felixomwansa/Multi-Protocol-Board---MPB-01/doc/block diagram.pdf

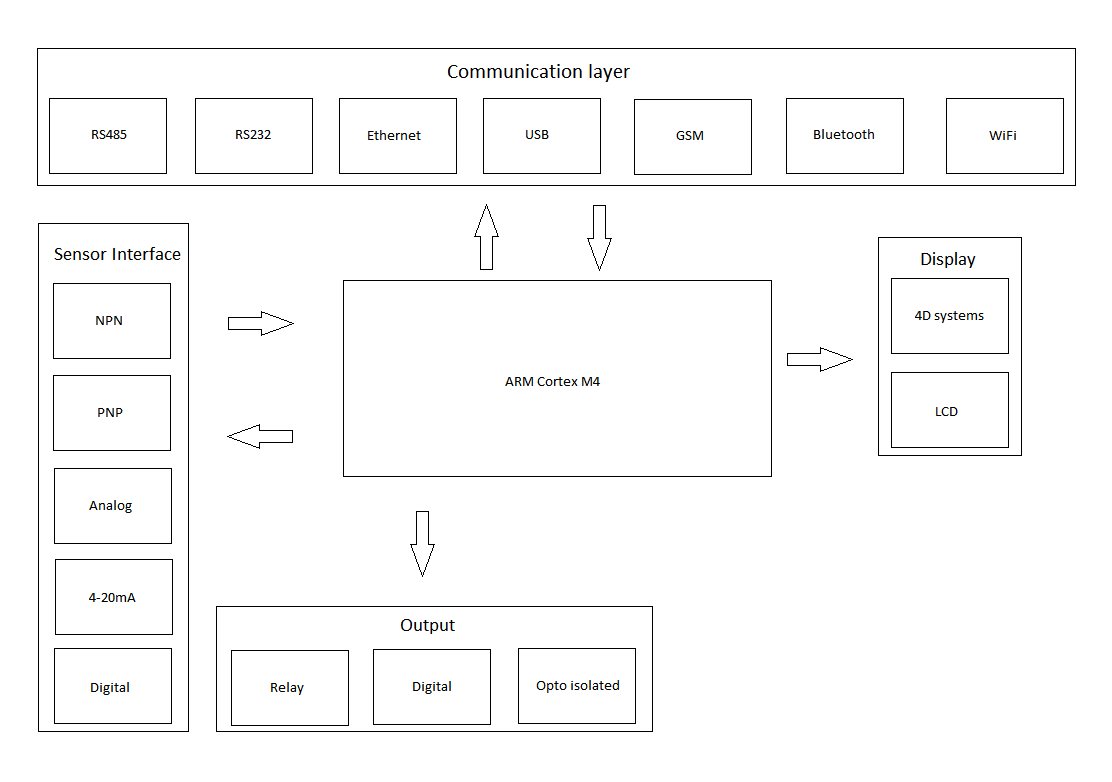
[picture p1: figure]
