felixomwansa/Multi-Protocol-Board---MPB-01/doc/PinmapVET6.jpg

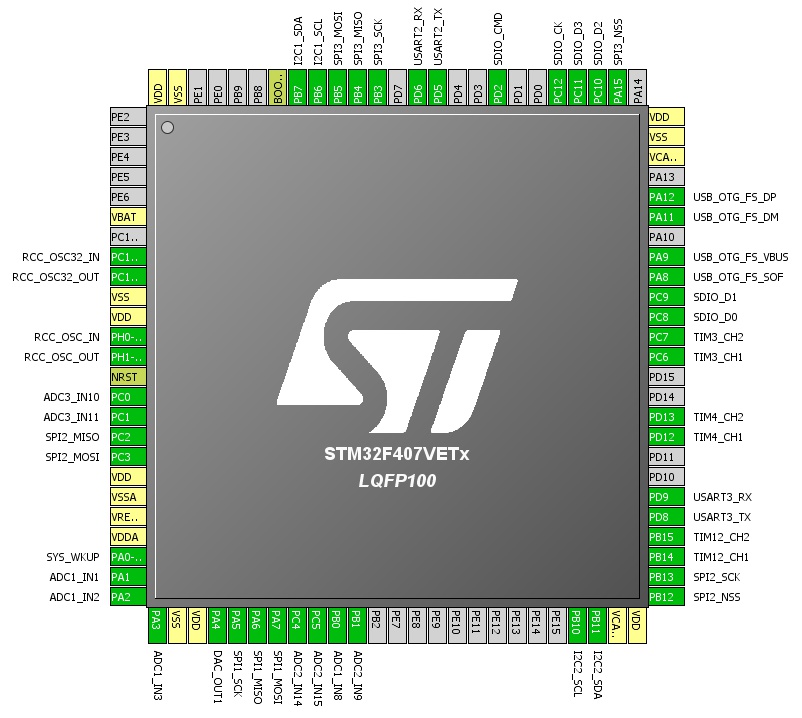
doc/PinmapVET6.jpg
