felixomwansa/Multi-Protocol-Board---MPB-01/v1.1 - Serial COM board/schema_mpb_1_1_Serial.brd

## EAGLE design v1.1 - Serial COM board/schema_mpb_1_1_Serial.brd (2019-08-02)

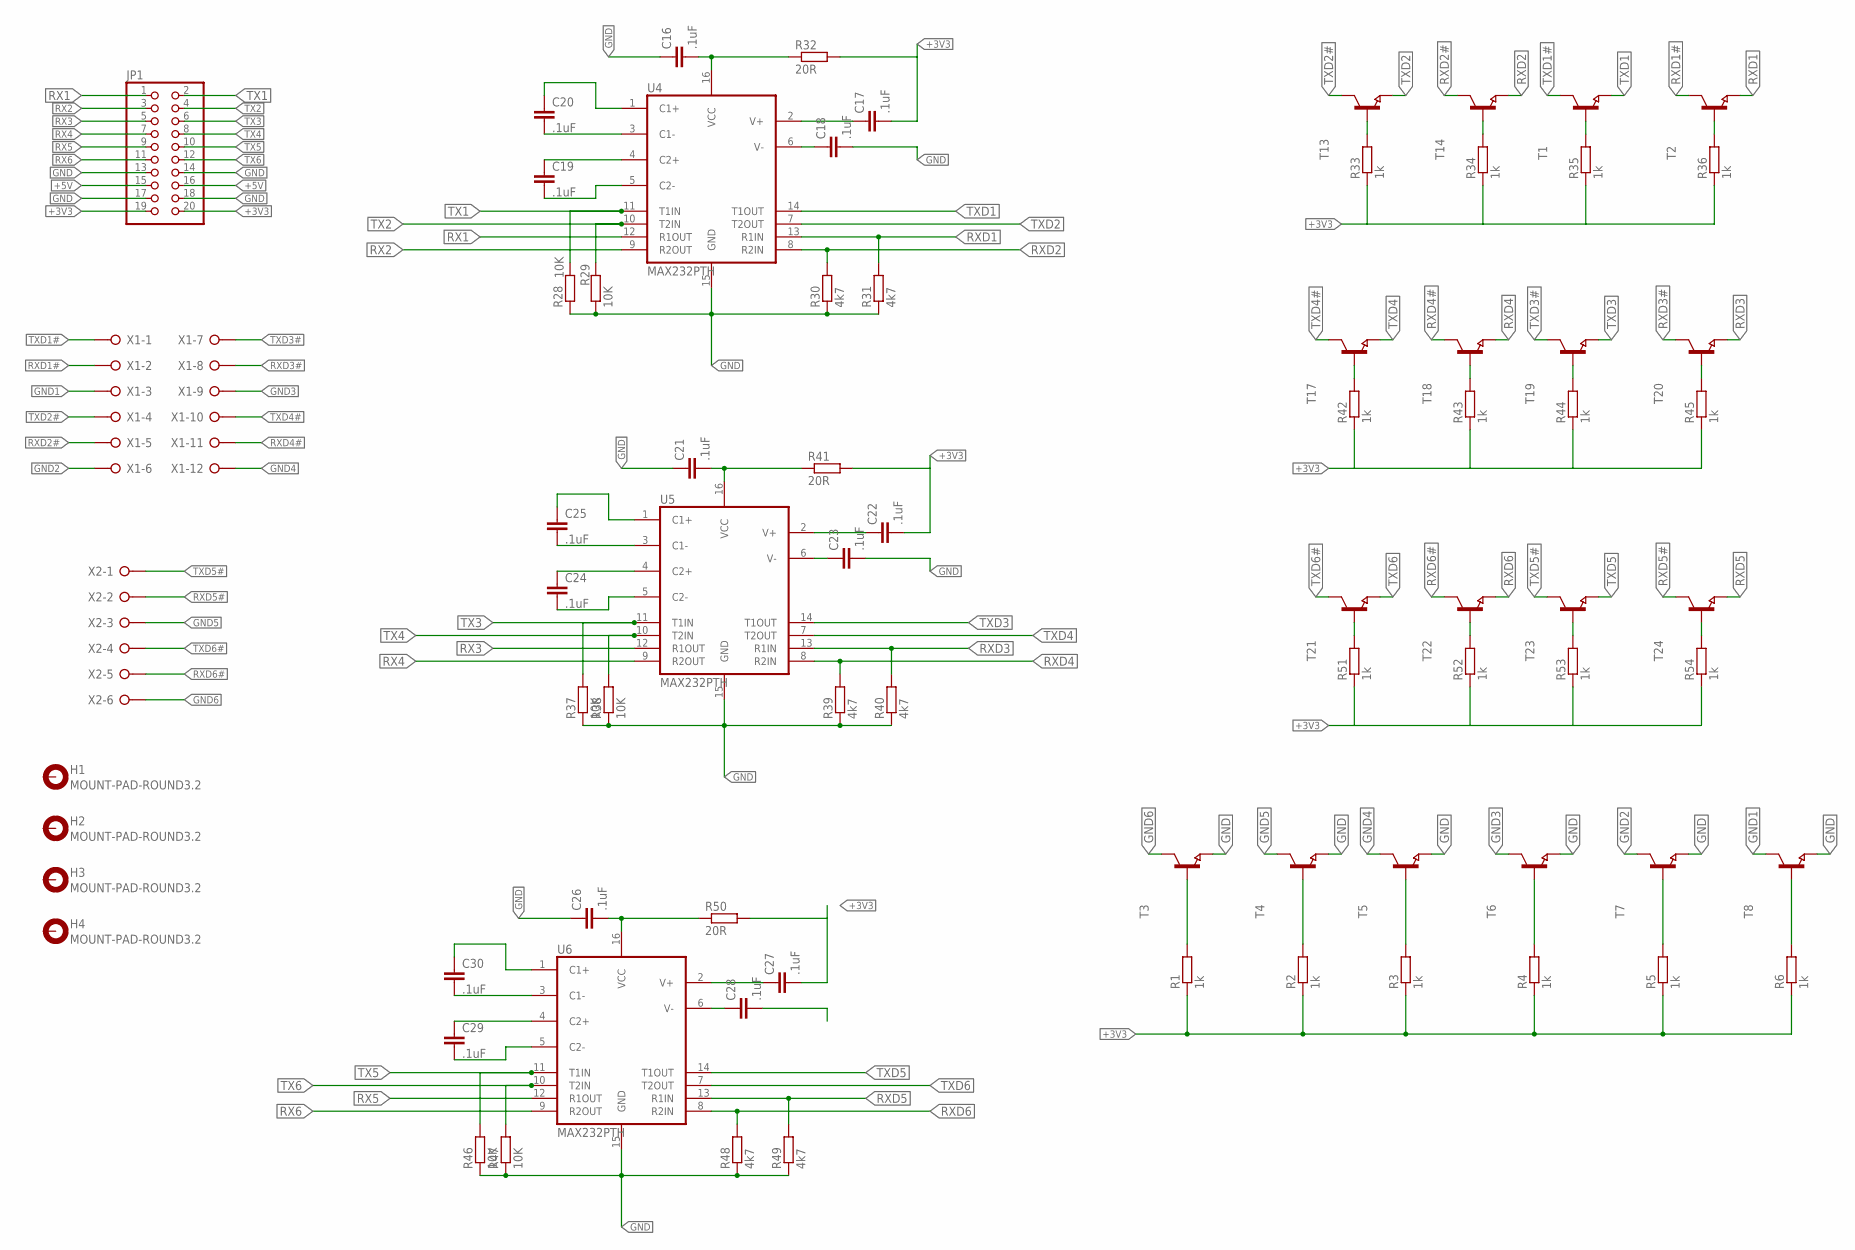
[picture p5: schematic schema_mpb_1_1_Serial.sch]

Parts:
C16, C17, C18, C19, C20, C21, C22, C23, C24, C25, C26, C27, C28, C29, C30: .1uF; C0603
H1, H2, H3, H4: MOUNT-PAD-ROUND3.2; 3,2-PAD
JP1: PINHD-2X10; 2X10
R1, R2, R3, R4, R5, R6, R33, R34, R35, R36, R42, R43, R44, R45, R51, R52, R53, R54: 1k; R0603
R28, R29, R37, R38, R46, R47: 10K; R0603
R30, R31, R39, R40, R48, R49: 4k7; R0603
R32, R41, R50: 20R; R0603
T1, T2, T3, T4, T5, T6, T7, T8, T13, T14, T17, T18, T19, T20, T21, T22, T23, T24: NPN-TRANSISTOR_SOT23; SOT23
U4, U5, U6: MAX232PTH; DIL16
X1: W237-12P
X2: W237-06P; W237-6P

Connections:
+3V3: C17.2, C22.2, C27.2, JP1.19, JP1.20, R1.1, R2.1, R3.1, R4.1, R5.1, R6.1, R32.2, R33.1, R34.1, R35.1, R36.1, R41.2, R42.1, R43.1, R44.1, R45.1, R50.2, R51.1, R52.1, R53.1, R54.1
+5V: JP1.15, JP1.16
GND: C16.1, C18.2, C21.1, C23.2, C26.1, C28.2, JP1.13, JP1.14, JP1.17, JP1.18, R28.1, R29.1, R30.1, R31.1, R37.1, R38.1, R39.1, R40.1, R46.1, R47.1, R48.1, R49.1, T3.2 (E), T4.2 (E), T5.2 (E), T6.2 (E), T7.2 (E), T8.2 (E), U4.15 (GND), U5.15 (GND), U6.15 (GND)
GND1: T8.3 (C), X1.3
GND2: T7.3 (C), X1.6
GND3: T6.3 (C), X1.9
GND4: T5.3 (C), X1.12
GND5: T4.3 (C), X2.3
GND6: T3.3 (C), X2.6
unnamed: R1.2, T3.1 (B)
unnamed: R2.2, T4.1 (B)
unnamed: R3.2, T5.1 (B)
unnamed: R4.2, T6.1 (B)
unnamed: R5.2, T7.1 (B)
unnamed: R6.2, T8.1 (B)
unnamed: C20.2, U4.3 (C1-)
unnamed: C20.1, U4.1 (C1+)
unnamed: C19.2, U4.5 (C2-)
unnamed: C19.1, U4.4 (C2+)
unnamed: C18.1, U4.6 (V-)
unnamed: C16.2, R32.1, U4.16 (VCC)
unnamed: C17.1, U4.2 (V+)
unnamed: R33.2, T13.1 (B)
unnamed: R34.2, T14.1 (B)
unnamed: R35.2, T1.1 (B)
unnamed: R36.2, T2.1 (B)
unnamed: C25.2, U5.3 (C1-)
unnamed: C25.1, U5.1 (C1+)
unnamed: C24.2, U5.5 (C2-)
unnamed: C24.1, U5.4 (C2+)
unnamed: C23.1, U5.6 (V-)
unnamed: C21.2, R41.1, U5.16 (VCC)
unnamed: C22.1, U5.2 (V+)
unnamed: R42.2, T17.1 (B)
unnamed: R43.2, T18.1 (B)
unnamed: R44.2, T19.1 (B)
unnamed: R45.2, T20.1 (B)
unnamed: C30.2, U6.3 (C1-)
unnamed: C30.1, U6.1 (C1+)
unnamed: C29.2, U6.5 (C2-)
unnamed: C29.1, U6.4 (C2+)
unnamed: C28.1, U6.6 (V-)
unnamed: C26.2, R50.1, U6.16 (VCC)
unnamed: C27.1, U6.2 (V+)
unnamed: R51.2, T21.1 (B)
unnamed: R52.2, T22.1 (B)
unnamed: R53.2, T23.1 (B)
unnamed: R54.2, T24.1 (B)
RX1: JP1.1, U4.12 (R1OUT)
RX2: JP1.3, U4.9 (R2OUT)
RX3: JP1.5, U5.12 (R1OUT)
RX4: JP1.7, U5.9 (R2OUT)
RX5: JP1.9, U6.12 (R1OUT)
RX6: JP1.11, U6.9 (R2OUT)
RXD1: R31.2, T2.2 (E), U4.13 (R1IN)
RXD1#: T2.3 (C), X1.2
RXD2: R30.2, T14.2 (E), U4.8 (R2IN)
RXD2#: T14.3 (C), X1.5
RXD3: R40.2, T20.2 (E), U5.13 (R1IN)
RXD3#: T20.3 (C), X1.8
RXD4: R39.2, T18.2 (E), U5.8 (R2IN)
RXD4#: T18.3 (C), X1.11
RXD5: R49.2, T24.2 (E), U6.13 (R1IN)
RXD5#: T24.3 (C), X2.2
RXD6: R48.2, T22.2 (E), U6.8 (R2IN)
RXD6#: T22.3 (C), X2.5
TX1: JP1.2, R28.2, U4.11 (T1IN)
TX2: JP1.4, R29.2, U4.10 (T2IN)
TX3: JP1.6, R37.2, U5.11 (T1IN)
TX4: JP1.8, R38.2, U5.10 (T2IN)
TX5: JP1.10, R46.2, U6.11 (T1IN)
TX6: JP1.12, R47.2, U6.10 (T2IN)
TXD1: T1.2 (E), U4.14 (T1OUT)
TXD1#: T1.3 (C), X1.1
TXD2: T13.2 (E), U4.7 (T2OUT)
TXD2#: T13.3 (C), X1.4
TXD3: T19.2 (E), U5.14 (T1OUT)
TXD3#: T19.3 (C), X1.7
TXD4: T17.2 (E), U5.7 (T2OUT)
TXD4#: T17.3 (C), X1.10
TXD5: T23.2 (E), U6.14 (T1OUT)
TXD5#: T23.3 (C), X2.1
TXD6: T21.2 (E), U6.7 (T2OUT)
TXD6#: T21.3 (C), X2.4

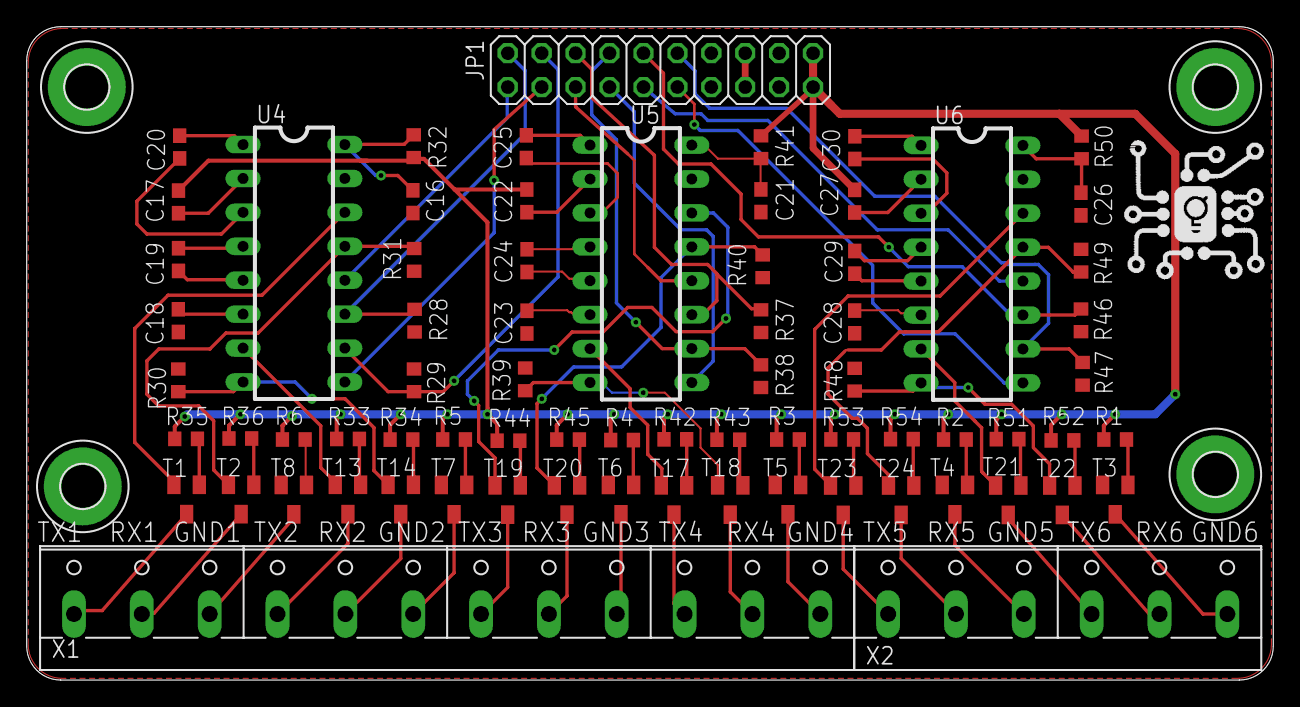
[picture p6: board schema_mpb_1_1_Serial.brd from above]

Board: 2 copper layers, 93.3 x 48.9 mm, 76 parts (0 on the bottom side), 84 nets.
