felixomwansa/Multi-Protocol-Board---MPB-01/v1.1 - COM board/schema_mpb_1_1_COM.brd

## EAGLE design v1.1 - COM board/schema_mpb_1_1_COM.brd (2019-08-02)

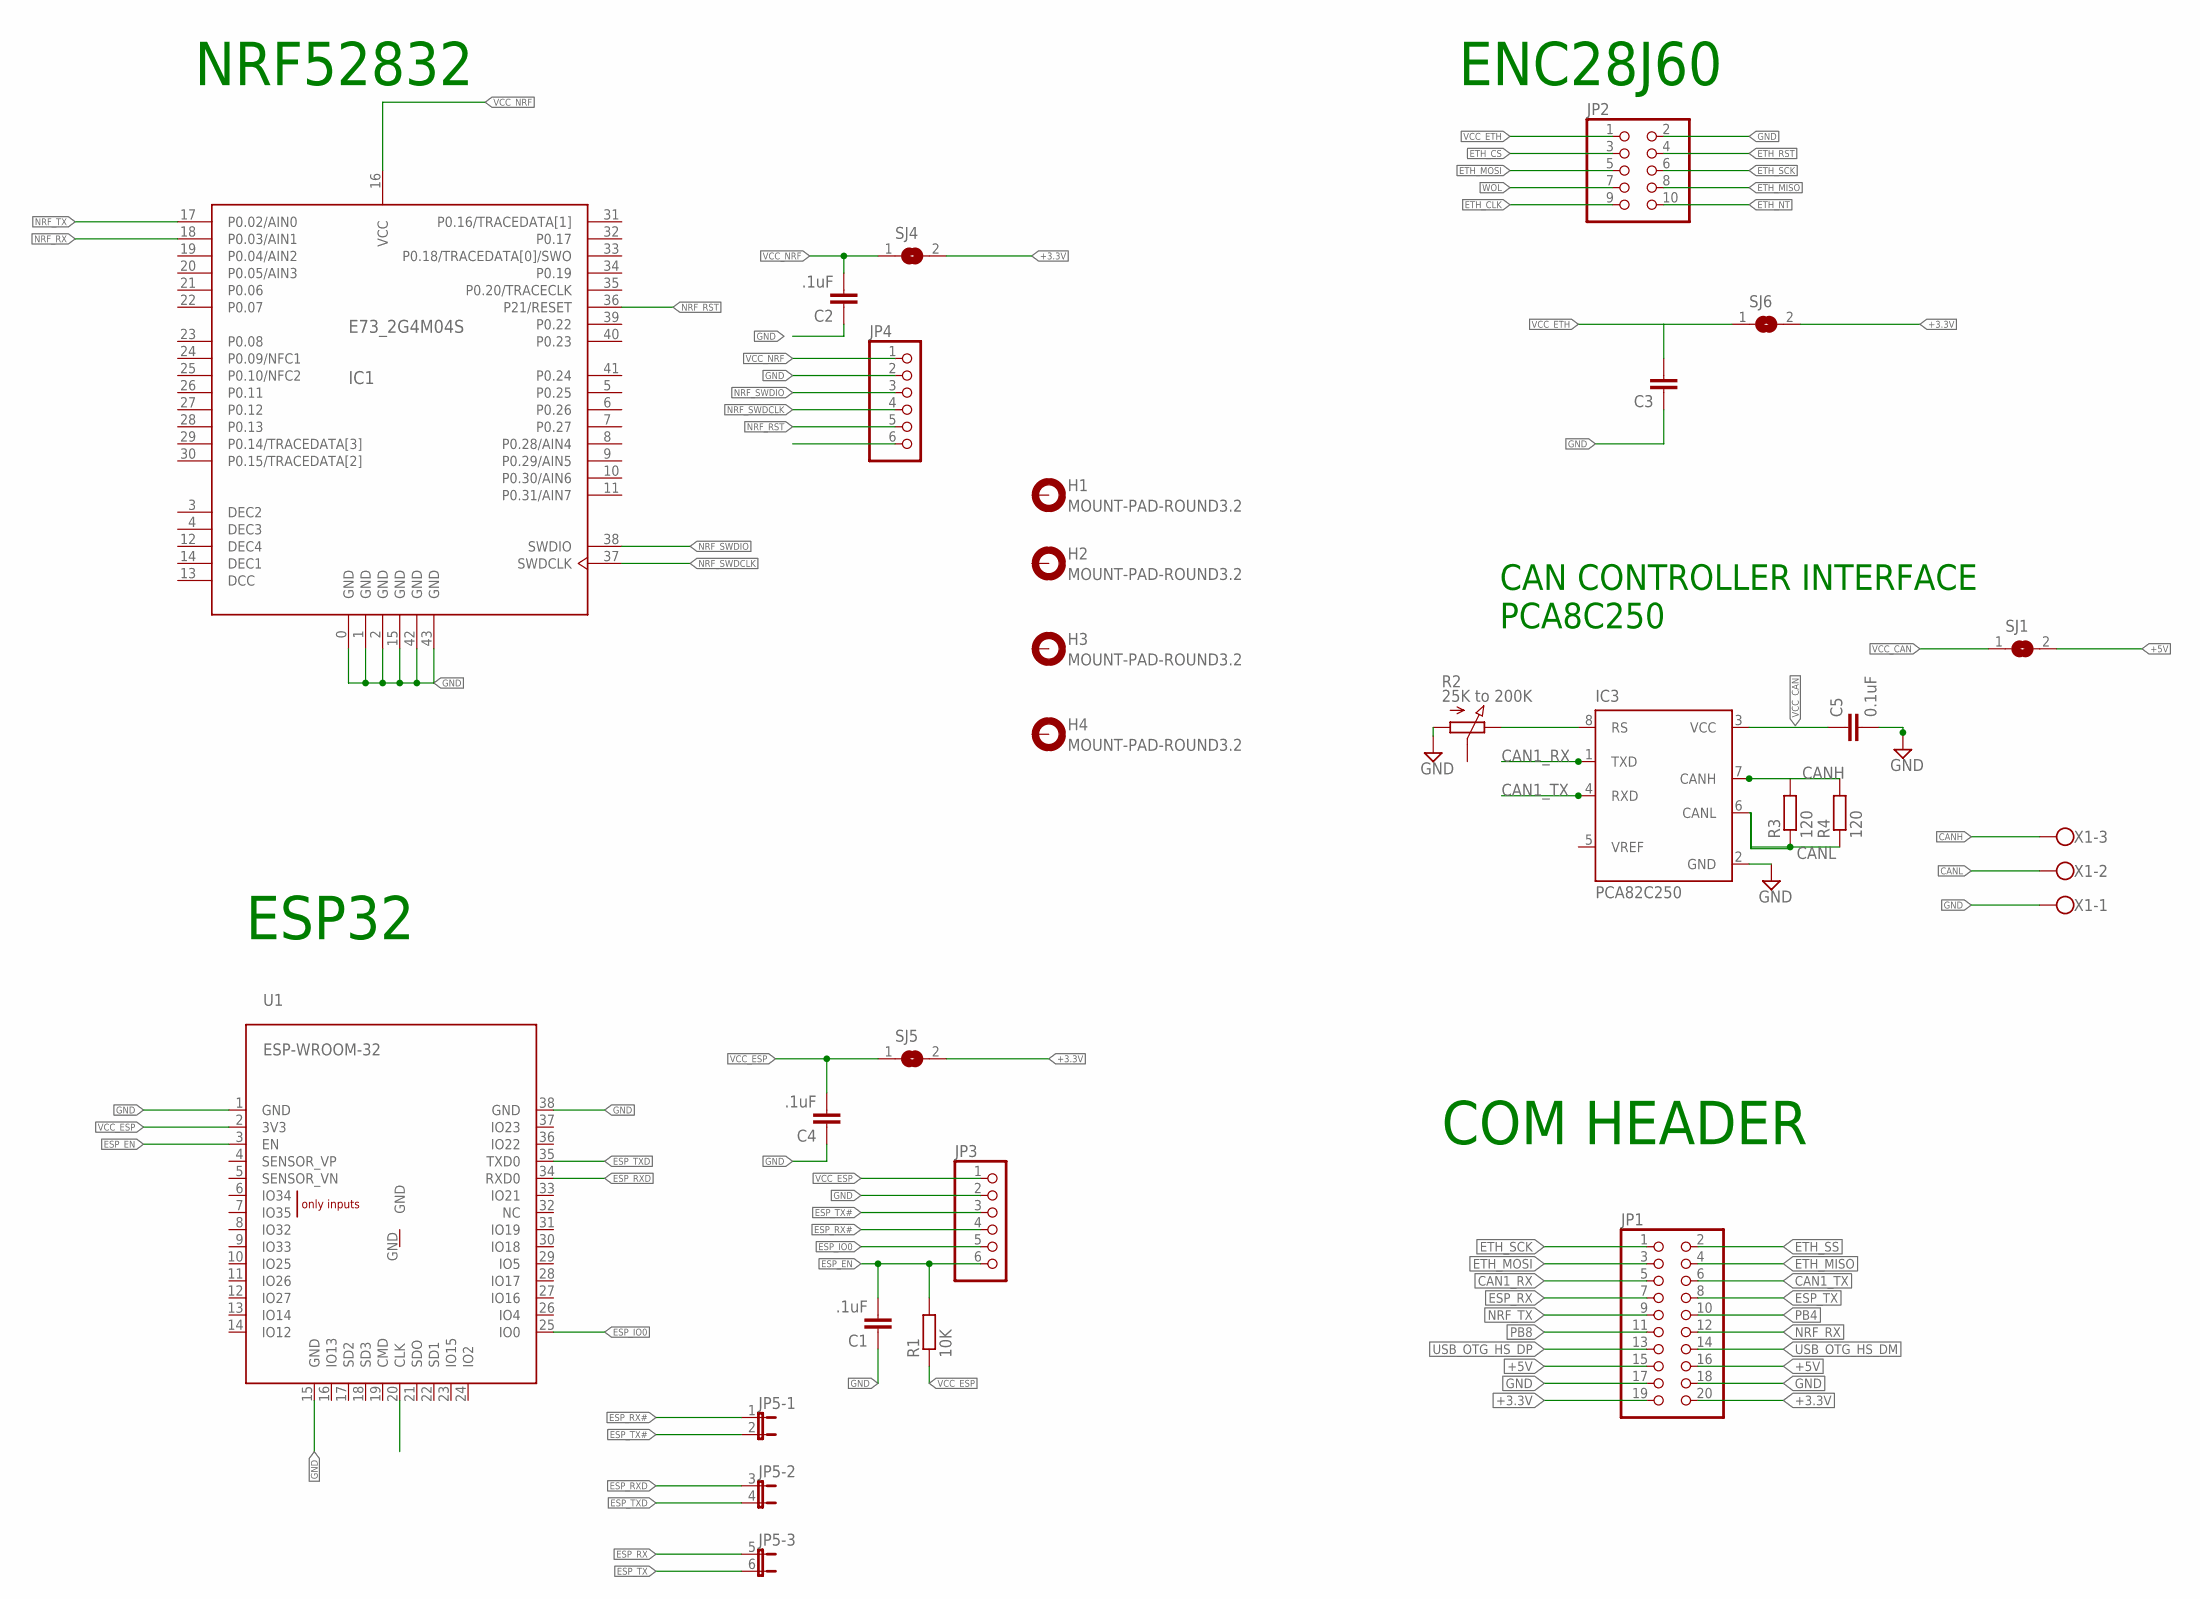
[picture p7: schematic schema_mpb_1_1_COM.sch, sheet 1]

Parts:
C1, C2, C4: .1uF; C0603
C3: C-EUC0603; C0603
C5: 0.1uF; C0805
H1, H2, H3, H4: MOUNT-PAD-ROUND3.2; 3,2-PAD
IC1: E73_2G4M04S
IC3: PCA82C250; DIL08
JP1: PINHD-2X10; 2X10
JP2: PINHD-2X5; 2X05
JP3, JP4: PINHD-1X6; 1X06
JP5: JP3QE; JP3Q
R1: 10K; R0603
R2: 25K to 200K; PC25
R3, R4: 120; R0805
SJ1, SJ4, SJ5, SJ6: SJW
U1: ESP-WROOM-32
X1: W237-103

Connections:
+3.3V: JP1.19, JP1.20, SJ4.2, SJ5.2, SJ6.2
+5V: JP1.15, JP1.16, SJ1.2
CAN1_RX: IC3.1 (TXD), JP1.5
CAN1_TX: IC3.4 (RXD), JP1.6
CANH: IC3.7 (CANH), R3.2, R4.2, X1.3
CANL: IC3.6 (CANL), R3.1, R4.1, X1.2
DCC: IC1.13 (DCC)
DEC1: IC1.14 (DEC1)
DEC2: IC1.3 (DEC2)
DEC3: IC1.4 (DEC3)
DEC4: IC1.12 (DEC4)
ESP_EN: C1.2, JP3.6, R1.2, U1.3 (EN)
ESP_IO0: JP3.5, U1.25 (IO0)
ESP_RX: JP1.7, JP5.5 (1)
ESP_RX#: JP3.4, JP5.1
ESP_RXD: JP5.3 (1), U1.34 (RXD0)
ESP_TX: JP1.8, JP5.6 (2)
ESP_TX#: JP3.3, JP5.2
ESP_TXD: JP5.4 (2), U1.35 (TXD0)
ETH_CLK: JP2.9
ETH_CS: JP2.3
ETH_MISO: JP1.4, JP2.8
ETH_MOSI: JP1.3, JP2.5
ETH_NT: JP2.10
ETH_RST: JP2.4
ETH_SCK: JP1.1, JP2.6
ETH_SS: JP1.2
GND: C1.1, C2.1, C3.1, C4.1, C5.2, IC1.0 (GND), IC1.1 (GND), IC1.2 (GND), IC1.15 (GND), IC1.42 (GND), IC1.43 (GND), IC3.2 (GND), JP1.17, JP1.18, JP2.2, JP3.2, JP4.2, R2.A, U1.1 (GND), U1.15 (GND), U1.38 (GND), X1.1
unnamed: IC3.8 (RS), R2.E
NRF_RST: IC1.36 (P21/RESET), JP4.5
NRF_RX: IC1.18 (P0.03/AIN1), JP1.12
NRF_SWDCLK: IC1.37 (SWDCLK), JP4.4
NRF_SWDIO: IC1.38 (SWDIO), JP4.3
NRF_TX: IC1.17 (P0.02/AIN0), JP1.9
PB4: JP1.10
PB8: JP1.11
USB_OTG_HS_DM: JP1.14
USB_OTG_HS_DP: JP1.13
VCC_CAN: C5.1, IC3.3 (VCC), SJ1.1
VCC_ESP: C4.2, JP3.1, R1.1, SJ5.1, U1.2 (3V3)
VCC_ETH: C3.2, JP2.1, SJ6.1
VCC_NRF: C2.2, IC1.16 (VCC), JP4.1, SJ4.1
WOL: JP2.7

Notes on the sheet:
ENC28J60
ESP32
COM HEADER
NRF52832
CAN CONTROLLER INTERFACE PCA8C250

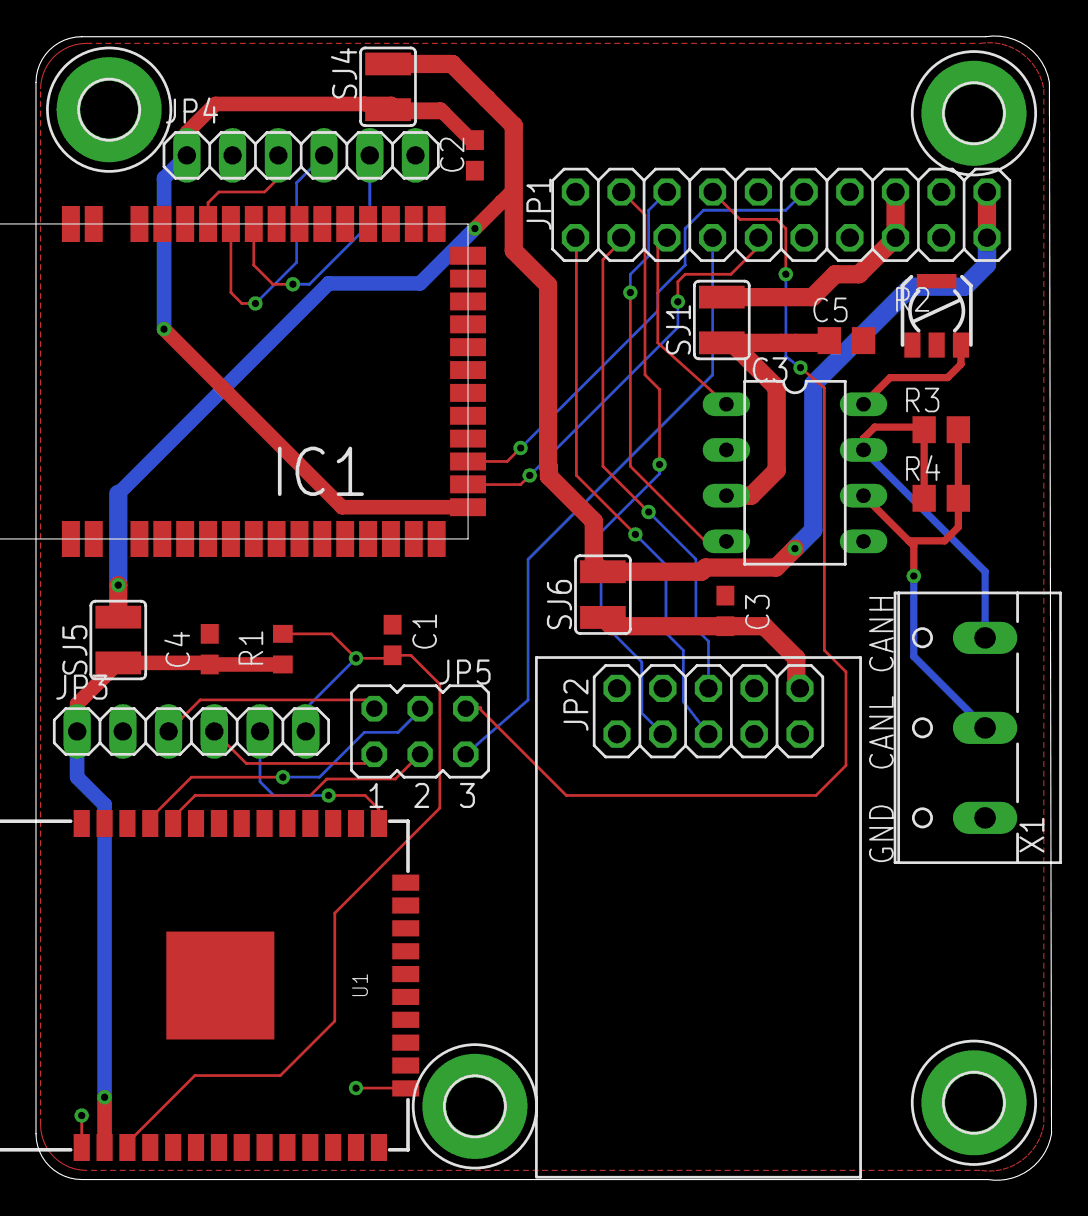
[picture p8: board schema_mpb_1_1_COM.brd from above]

Board: 2 copper layers, 56.4 x 63.6 mm, 26 parts (0 on the bottom side), 28 nets.
