felixomwansa/Multi-Protocol-Board---MPB-01/v1.1 - IO board/schema_mpb1_1_IO.brd

## EAGLE design v1.1 - IO board/schema_mpb1_1_IO.brd (2019-08-02)

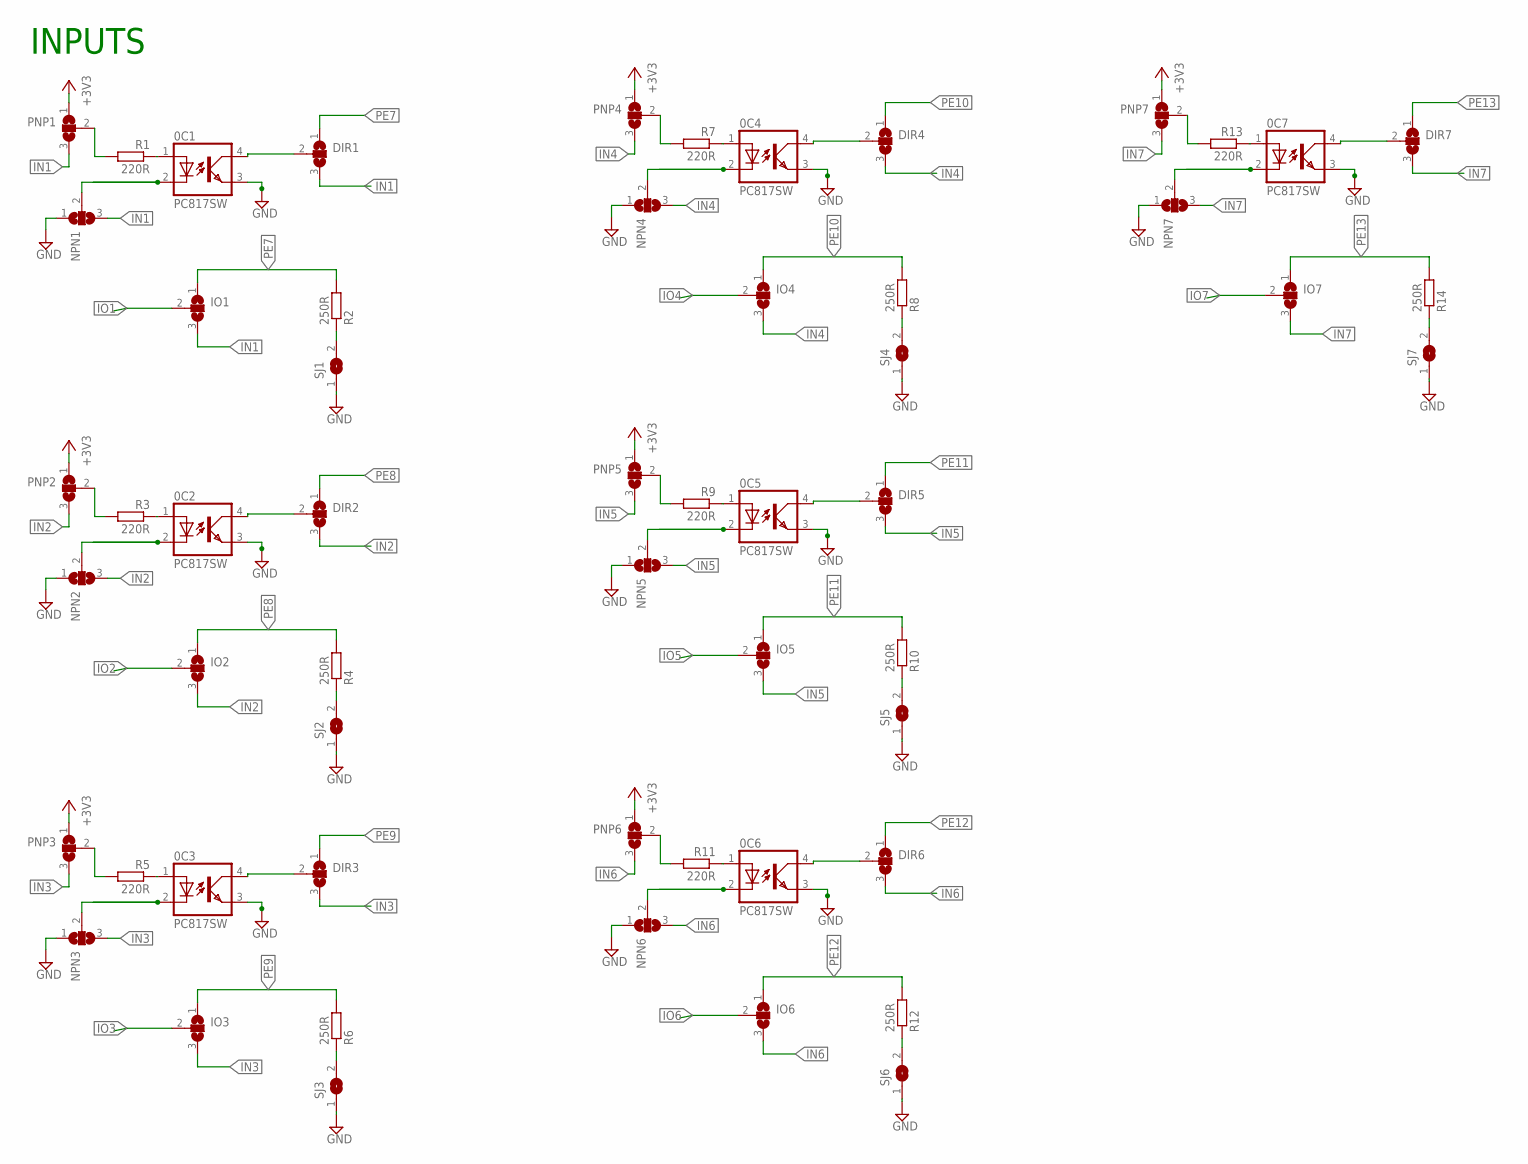
[picture p9: schematic schema_mpb1_1_IO.sch, sheet 1, INPUTS]

Parts:
0C1, 0C2, 0C3, 0C4, 0C5, 0C6, 0C7: PC817SW; PC817SMTW
DIR1, DIR2, DIR3, DIR4, DIR5, DIR6, DIR7: SJ2W; SJ_2
IO1, IO2, IO3, IO4, IO5, IO6, IO7: SJ2W; SJ_2
NPN1, NPN2, NPN3, NPN4, NPN5, NPN6, NPN7: SJ2W; SJ_2
PNP1, PNP2, PNP3, PNP4, PNP5, PNP6, PNP7: SJ2W; SJ_2
R1, R3, R5, R7, R9, R11, R13: 220R; R0603
R2, R4, R6, R8, R10, R12, R14: 250R; R0603
SJ1, SJ2, SJ3, SJ4, SJ5, SJ6, SJ7: SJ

Connections:
+3V3: PNP1.1, PNP2.1, PNP3.1, PNP4.1, PNP5.1, PNP6.1, PNP7.1; also elsewhere on the board
GND: 0C1.3 (EMIT), 0C2.3 (EMIT), 0C3.3 (EMIT), 0C4.3 (EMIT), 0C5.3 (EMIT), 0C6.3 (EMIT), 0C7.3 (EMIT), NPN1.1, NPN2.1, NPN3.1, NPN4.1, NPN5.1, NPN6.1, NPN7.1, SJ1.1, SJ2.1, SJ3.1, SJ4.1, SJ5.1, SJ6.1, SJ7.1; also elsewhere on the board
IN1: DIR1.3, IO1.3, NPN1.3, PNP1.3
IN2: DIR2.3, IO2.3, NPN2.3, PNP2.3
IN3: DIR3.3, IO3.3, NPN3.3, PNP3.3
IN4: DIR4.3, IO4.3, NPN4.3, PNP4.3
IN5: DIR5.3, IO5.3, NPN5.3, PNP5.3
IN6: DIR6.3, IO6.3, NPN6.3, PNP6.3
IN7: DIR7.3, IO7.3, NPN7.3, PNP7.3
IO1: IO1.2; also elsewhere on the board
IO2: IO2.2; also elsewhere on the board
IO3: IO3.2; also elsewhere on the board
IO4: IO4.2; also elsewhere on the board
IO5: IO5.2; also elsewhere on the board
IO6: IO6.2; also elsewhere on the board
IO7: IO7.2; also elsewhere on the board
unnamed: PNP1.2, R1.2
unnamed: R2.1, SJ1.2
unnamed: PNP2.2, R3.2
unnamed: 0C2.1 (A), R3.1
unnamed: 0C2.2 (C), NPN2.2
unnamed: 0C2.4 (COL), DIR2.2
unnamed: R4.1, SJ2.2
unnamed: PNP3.2, R5.2
unnamed: 0C3.1 (A), R5.1
unnamed: 0C3.2 (C), NPN3.2
unnamed: 0C3.4 (COL), DIR3.2
unnamed: R6.1, SJ3.2
unnamed: PNP4.2, R7.2
unnamed: 0C4.1 (A), R7.1
unnamed: 0C4.2 (C), NPN4.2
unnamed: 0C4.4 (COL), DIR4.2
unnamed: R8.1, SJ4.2
unnamed: PNP5.2, R9.2
unnamed: 0C5.1 (A), R9.1
unnamed: 0C5.2 (C), NPN5.2
unnamed: 0C5.4 (COL), DIR5.2
unnamed: R10.1, SJ5.2
unnamed: PNP6.2, R11.2
unnamed: 0C6.1 (A), R11.1
unnamed: 0C6.2 (C), NPN6.2
unnamed: 0C6.4 (COL), DIR6.2
unnamed: R12.1, SJ6.2
unnamed: PNP7.2, R13.2
unnamed: 0C7.1 (A), R13.1
unnamed: 0C7.2 (C), NPN7.2
unnamed: 0C1.1 (A), R1.1
unnamed: 0C7.4 (COL), DIR7.2
unnamed: 0C1.2 (C), NPN1.2
unnamed: R14.1, SJ7.2
unnamed: 0C1.4 (COL), DIR1.2
PE7: DIR1.1, IO1.1, R2.2; also elsewhere on the board
PE8: DIR2.1, IO2.1, R4.2; also elsewhere on the board
PE9: DIR3.1, IO3.1, R6.2; also elsewhere on the board
PE10: DIR4.1, IO4.1, R8.2; also elsewhere on the board
PE11: DIR5.1, IO5.1, R10.2; also elsewhere on the board
PE12: DIR6.1, IO6.1, R12.2; also elsewhere on the board
PE13: DIR7.1, IO7.1, R14.2; also elsewhere on the board

Notes on the sheet:
INPUTS

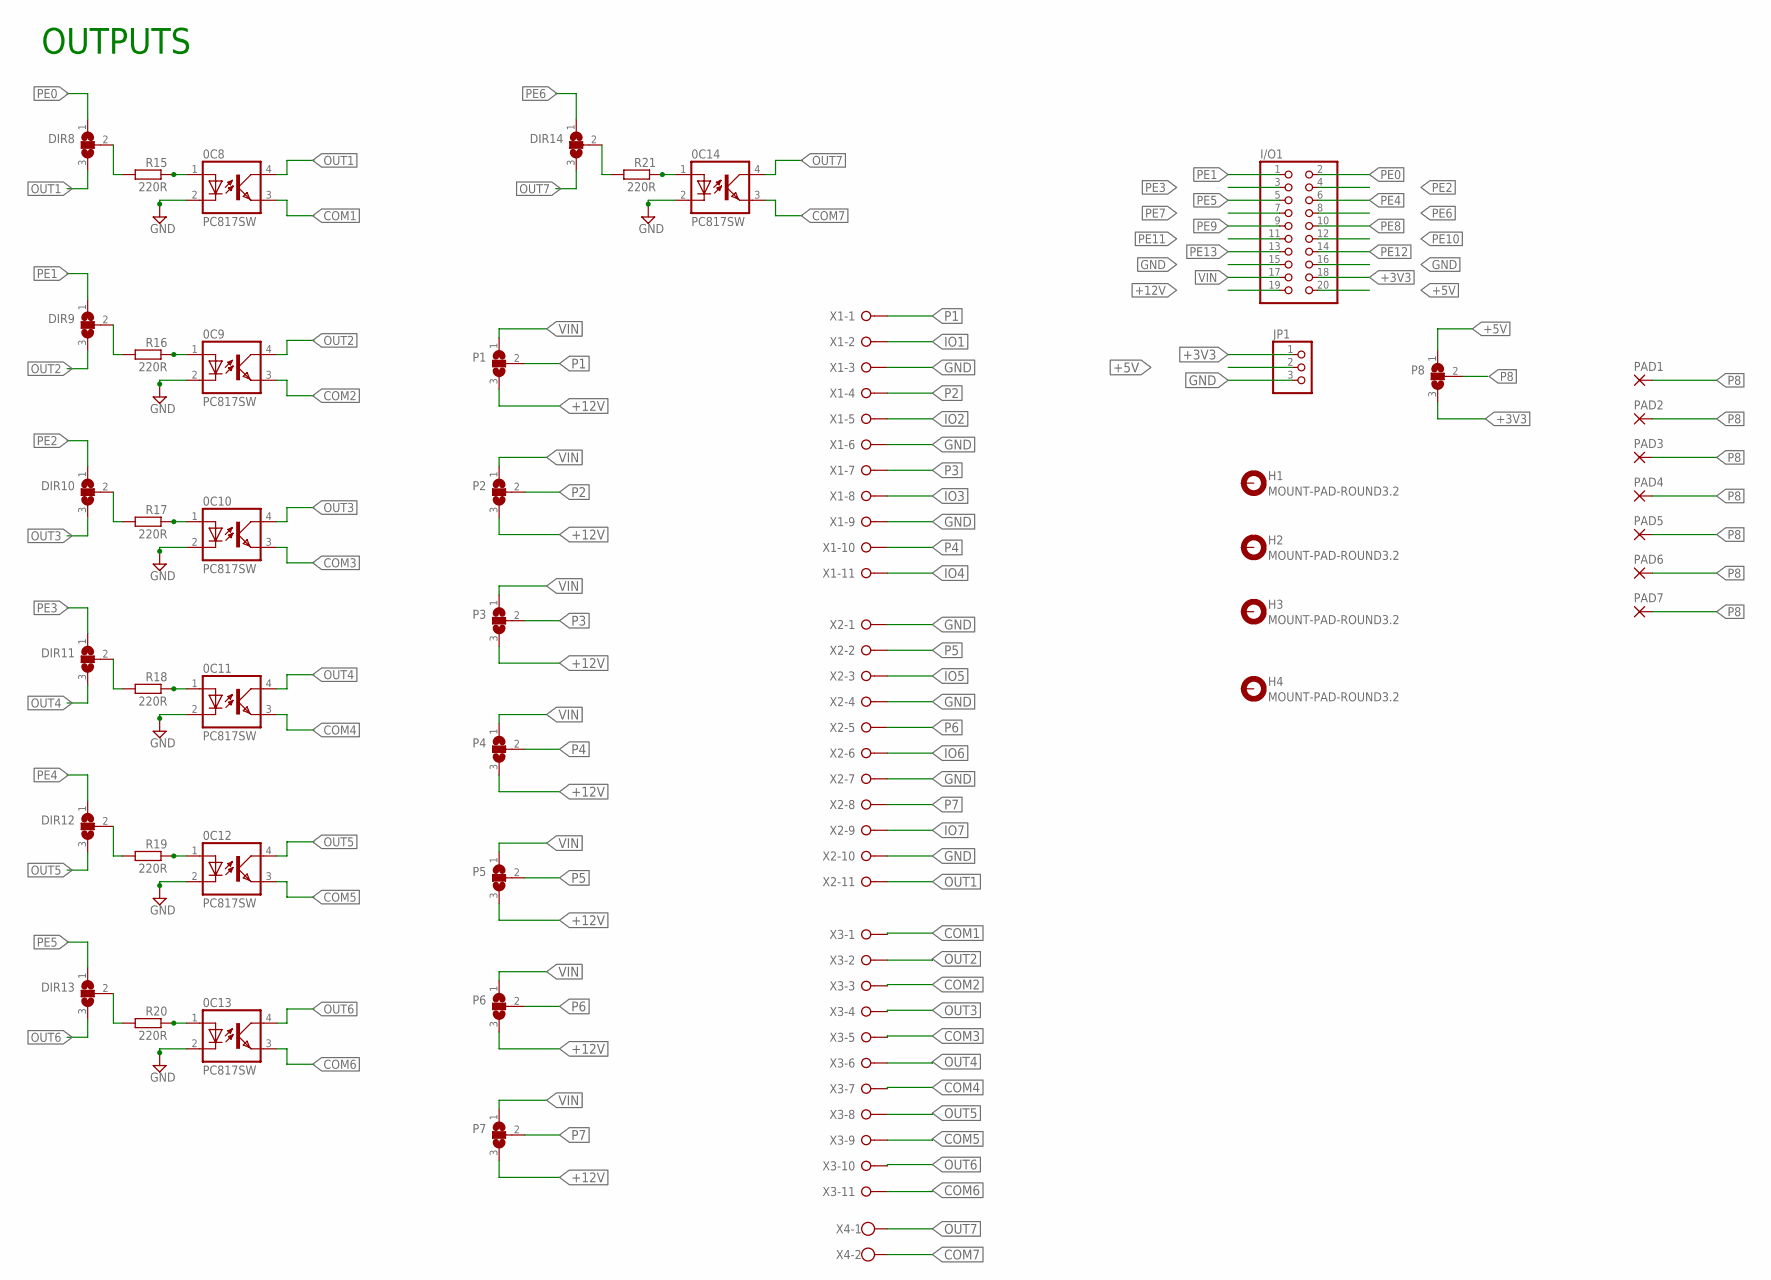
[picture p10: schematic schema_mpb1_1_IO.sch, sheet 2, OUTPUTS]

Parts:
0C8, 0C9, 0C10, 0C11, 0C12, 0C13, 0C14: PC817SW; PC817SMTW
DIR8, DIR9, DIR10, DIR11, DIR12, DIR13, DIR14: SJ2W; SJ_2
H1, H2, H3, H4: MOUNT-PAD-ROUND3.2; 3,2-PAD
I/O1: PINHD-2X10_2.54; 2X10
JP1: PINHD-1X3; 1X03
P1, P2, P3, P4, P5, P6, P7, P8: SJ2WW; SJ_2W
PAD1, PAD2, PAD3, PAD4, PAD5, PAD6, PAD7: SMD2; SMD1,27-2,54
R15, R16, R17, R18, R19, R20, R21: 220R; R0603
X1, X2, X3: W237-11P
X4: W237-102

Connections:
+3V3: I/O1.18, JP1.1, P8.3; also elsewhere on the board
+5V: I/O1.20, JP1.2, P8.1
+12V: I/O1.19, P1.3, P2.3, P3.3, P4.3, P5.3, P6.3, P7.3
COM1: 0C8.3 (EMIT), X3.1
COM2: 0C9.3 (EMIT), X3.3
COM3: 0C10.3 (EMIT), X3.5
COM4: 0C11.3 (EMIT), X3.7
COM5: 0C12.3 (EMIT), X3.9
COM6: 0C13.3 (EMIT), X3.11
COM7: 0C14.3 (EMIT), X4.2
GND: 0C8.2 (C), 0C9.2 (C), 0C10.2 (C), 0C11.2 (C), 0C12.2 (C), 0C13.2 (C), 0C14.2 (C), I/O1.15, I/O1.16, JP1.3, X1.3, X1.6, X1.9, X2.1, X2.4, X2.7, X2.10; also elsewhere on the board
IO1: X1.2; also elsewhere on the board
IO2: X1.5; also elsewhere on the board
IO3: X1.8; also elsewhere on the board
IO4: X1.11; also elsewhere on the board
IO5: X2.3; also elsewhere on the board
IO6: X2.6; also elsewhere on the board
IO7: X2.9; also elsewhere on the board
unnamed: DIR14.2, R21.2
unnamed: 0C9.1 (A), R16.1
unnamed: DIR9.2, R16.2
unnamed: 0C10.1 (A), R17.1
unnamed: DIR10.2, R17.2
unnamed: 0C11.1 (A), R18.1
unnamed: DIR11.2, R18.2
unnamed: 0C12.1 (A), R19.1
unnamed: DIR12.2, R19.2
unnamed: 0C13.1 (A), R20.1
unnamed: DIR13.2, R20.2
unnamed: 0C14.1 (A), R21.1
unnamed: DIR8.2, R15.2
unnamed: 0C8.1 (A), R15.1
OUT1: 0C8.4 (COL), DIR8.3, X2.11
OUT2: 0C9.4 (COL), DIR9.3, X3.2
OUT3: 0C10.4 (COL), DIR10.3, X3.4
OUT4: 0C11.4 (COL), DIR11.3, X3.6
OUT5: 0C12.4 (COL), DIR12.3, X3.8
OUT6: 0C13.4 (COL), DIR13.3, X3.10
OUT7: 0C14.4 (COL), DIR14.3, X4.1
P1: P1.2, X1.1
P2: P2.2, X1.4
P3: P3.2, X1.7
P4: P4.2, X1.10
P5: P5.2, X2.2
P6: P6.2, X2.5
P7: P7.2, X2.8
P8: P8.2, PAD1.1, PAD2.1, PAD3.1, PAD4.1, PAD5.1, PAD6.1, PAD7.1
PE0: DIR8.1, I/O1.2
PE1: DIR9.1, I/O1.1
PE2: DIR10.1, I/O1.4
PE3: DIR11.1, I/O1.3
PE4: DIR12.1, I/O1.6
PE5: DIR13.1, I/O1.5
PE6: DIR14.1, I/O1.8
PE7: I/O1.7; also elsewhere on the board
PE8: I/O1.10; also elsewhere on the board
PE9: I/O1.9; also elsewhere on the board
PE10: I/O1.12; also elsewhere on the board
PE11: I/O1.11; also elsewhere on the board
PE12: I/O1.14; also elsewhere on the board
PE13: I/O1.13; also elsewhere on the board
VIN: I/O1.17, P1.1, P2.1, P3.1, P4.1, P5.1, P6.1, P7.1

Notes on the sheet:
OUTPUTS

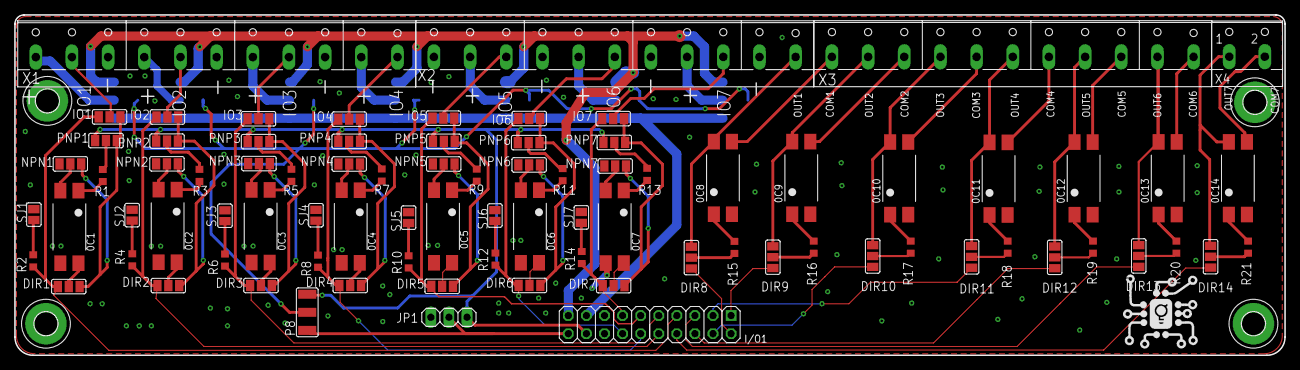
[picture p11: board schema_mpb1_1_IO.brd from above]

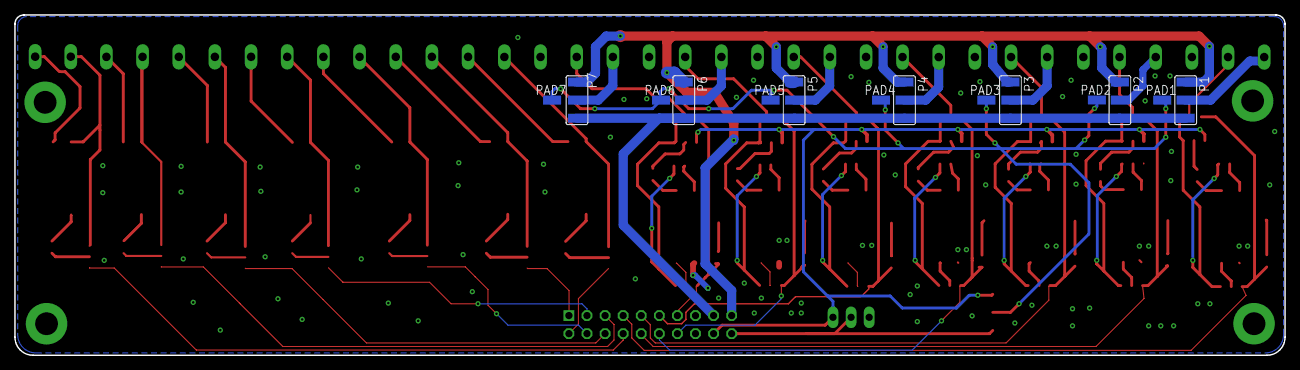
[picture p12: board schema_mpb1_1_IO.brd from below]

Board: 2 copper layers, 178.4 x 47.8 mm, 102 parts (14 on the bottom side), 104 nets.
