felixomwansa/Multi-Protocol-Board---MPB-01/v1.1 - Main board/schema_mpb1_1.brd

## EAGLE design v1.1 - Main board/schema_mpb1_1.brd (2019-07-17)

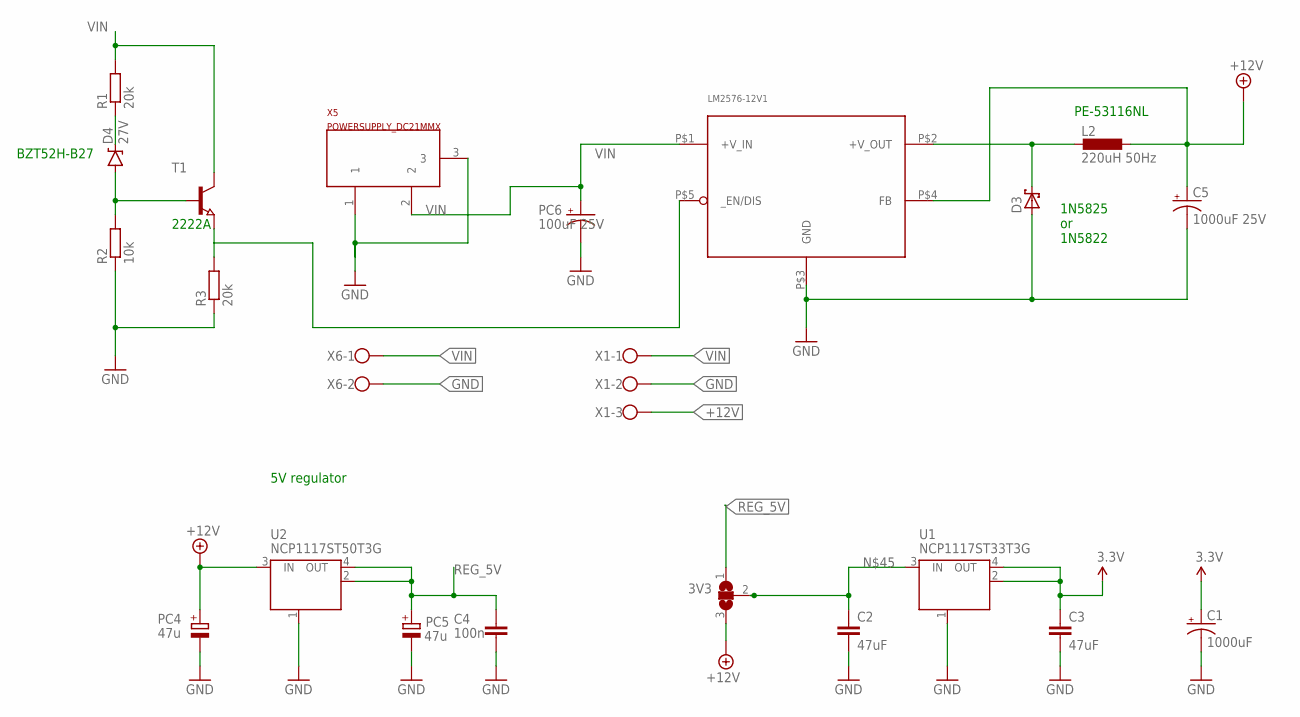
[picture p13: schematic schema_mpb1_1.sch, sheet 1, Power Conversion]

Parts:
3V3: SJ2W; SJ_2
C1: 1000uF; E5-6
C2, C3: 47uF; C0603
C4: 100n; C0603-ROUND
C5: 1000uF 25V; E5-6
D3: 1N5908; C4111-15
D4: 27V; SOD-123
L2: 220uH 50Hz; KM-4.0
LM2576-12V1: LM2576-T05D; TO220-5_STAGGERED
PC4, PC5: 47u; PANASONIC_D
PC6: 100uF 25V; E5-6
R1, R3: 20k; R0603
R2: 10k; R0603
T1: NPN-TRANSISTOR_SOT23; SOT23
U1: NCP1117ST33T3G; SOT223
U2: NCP1117ST50T3G; SOT223
X1: W237-103
X5: POWERSUPPLY_DC21MMX; POWERSUPPLY_DC-21MM
X6: W237-102

Connections:
3.3V: C1.+, C3.1, U1.2 (OUT), U1.4 (OUT); also elsewhere on the board
+12V: 3V3.3, C5.+, L2.P$2 (2), LM2576-12V1.P$4 (FB), PC4.+, U2.3 (IN), X1.3; also elsewhere on the board
GND: C1.-, C2.2, C3.2, C4.1, C5.-, D3.A, LM2576-12V1.P$3 (GND), PC4.-, PC5.-, PC6.-, R2.1, R3.1, U1.1 (GND/ADJ), U2.1 (GND/ADJ), X1.2, X5.1, X5.3, X6.2; also elsewhere on the board
unnamed: D3.C, L2.P$1 (1), LM2576-12V1.P$2 (+V_OUT)
unnamed: D4.A, R2.2, T1.1 (B)
unnamed: D4.C, R1.1
unnamed: LM2576-12V1.P$5 (_EN/DIS), R3.2, T1.2 (E)
unnamed: 3V3.2, C2.1, U1.3 (IN)
REG_5V: 3V3.1, C4.2, PC5.+, U2.2 (OUT), U2.4 (OUT); also elsewhere on the board
VIN: LM2576-12V1.P$1 (+V_IN), PC6.+, R1.2, T1.3 (C), X1.1, X5.2, X6.1; also elsewhere on the board

Notes on the sheet:
5V regulator
1N5825 or 1N5822
PE-53116NL
BZT52H-B27
2222A
