felixomwansa/Multi-Protocol-Board---MPB-01/v1.1 - Main board/schema_mpb1_1.brd

## EAGLE design v1.1 - Main board/schema_mpb1_1.brd (continued)

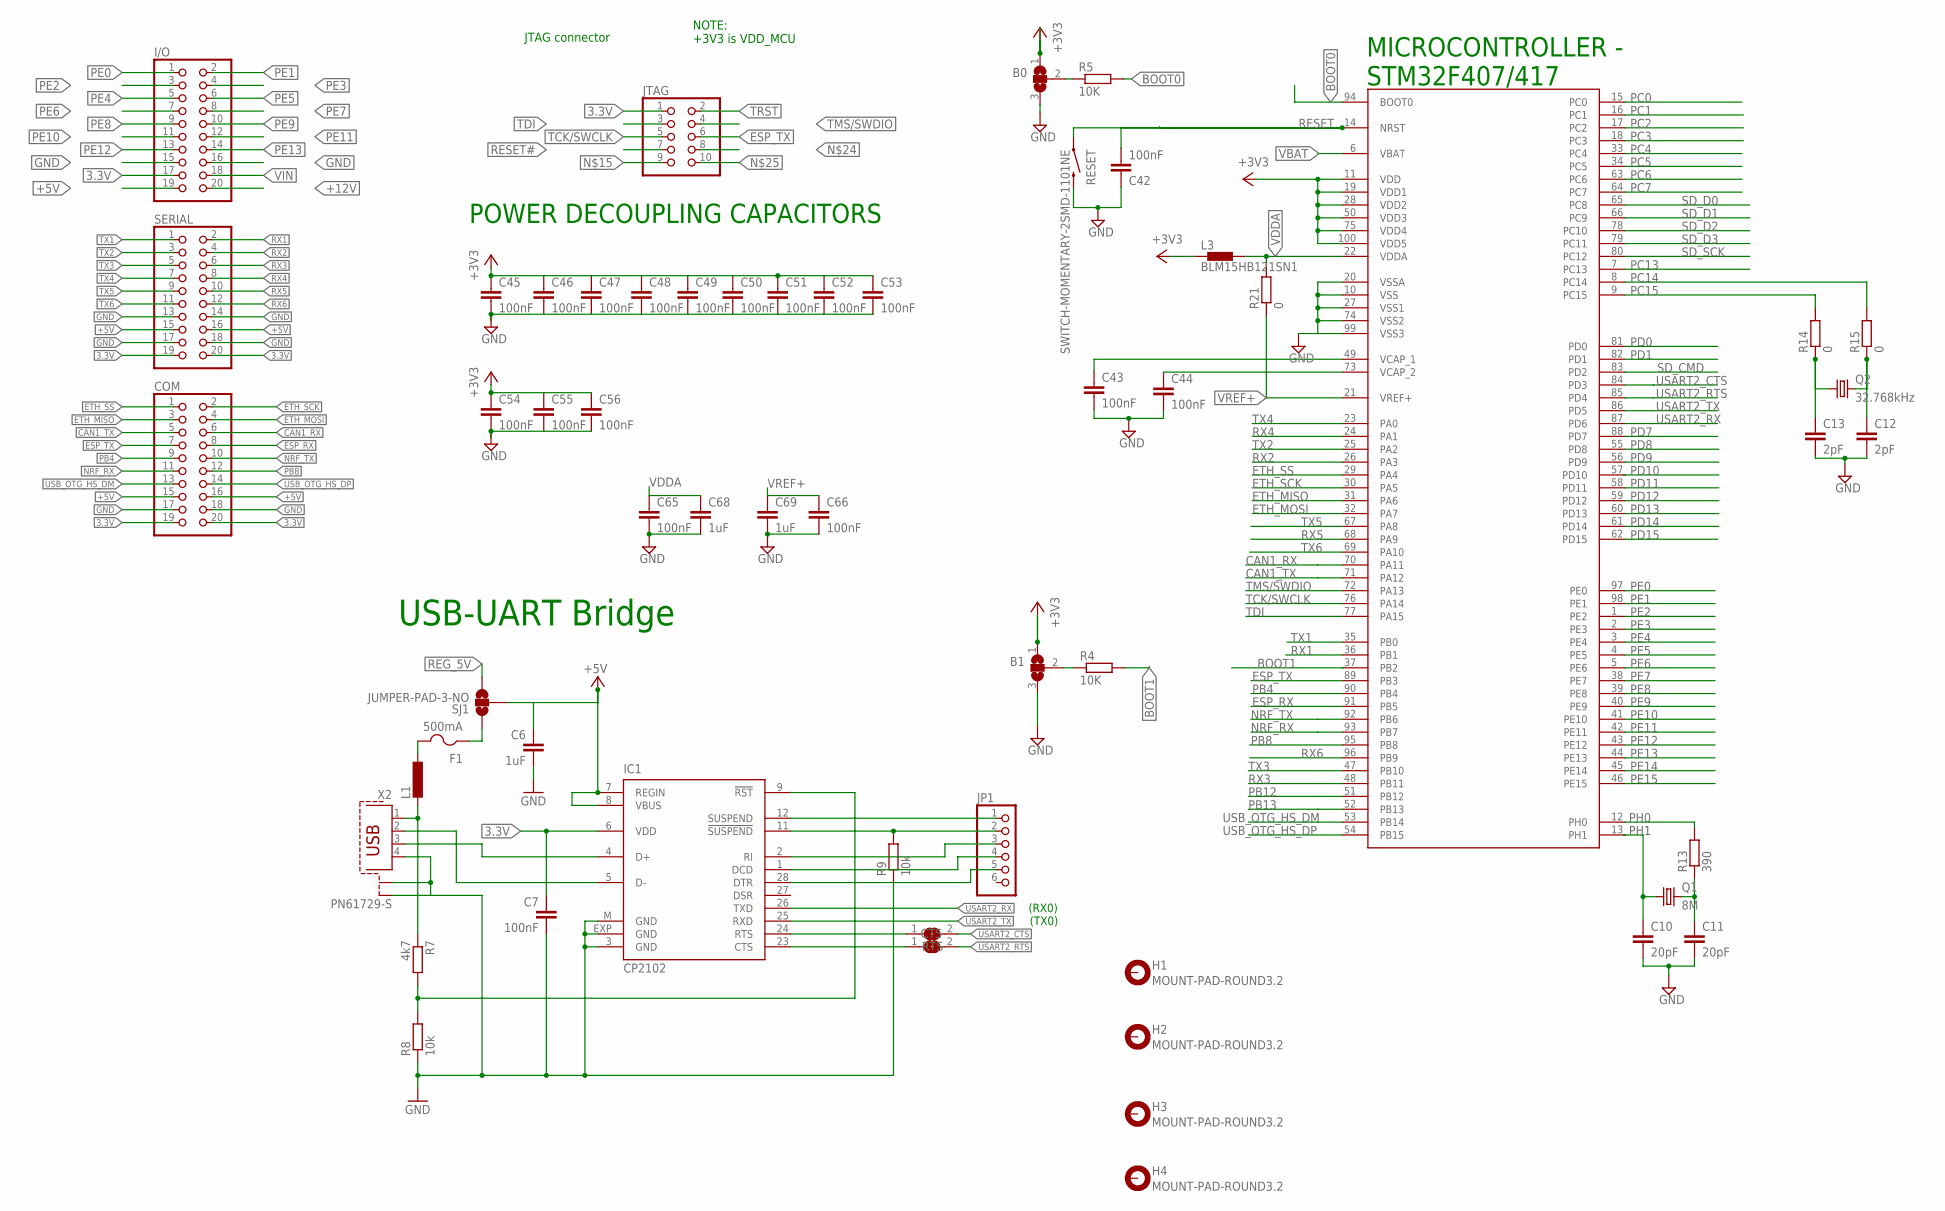
[picture p14: schematic schema_mpb1_1.sch, sheet 2, General Board Outline]

Parts:
B0, B1: SJ2W; SJ_2
C6: 1uF; C0603-ROUND
C7: 100nF; C0603-ROUND
C10, C11: 20pF; C0603
C12, C13: 2pF; C0603
C42, C43, C44, C45, C46, C47, C48, C49, C50, C51, C52, C53, C54, C55, C56, C65, C66: 100nF; C0603
C68, C69: 1uF; C0603
COM: PINHD-2X10_2.54; 2X10
CTS: SJ
F1: 500mA; 1812
H1, H2, H3, H4: MOUNT-PAD-ROUND3.2; 3,2-PAD
I/O: PINHD-2X10_2.54; 2X10
IC1: CP2102; MLP28
JP1: PINHD-1X6; 1X06
JTAG: PINHD-2X05_2.00; 2X05M
L1: L-EUL1812; L1812
L3: BLM15HB121SN1; 0402
Q1: 8M; HC49UP
Q2: 32.768kHz; HC49UP
R4, R5: 10K; R0603
R7: 4k7; R0603
R8, R9: 10k; R0603
R13: 390; R0603
R14, R15, R21: 0; R0603
RESET: SWITCH-MOMENTARY-2SMD-1101NE; TACTILE-SWITCH-1101NE
RTS: SJ
SERIAL: PINHD-2X10_2.54; 2X10
SJ1: JUMPER-PAD-3-NO; PAD-JUMPER-3-NO_YES_SILK_FULL_BOX_WIDE_SPACING
U$2: STM32F40XSTM32D40X; LQFP100
X2: PN61729-S

Connections:
3.3V: B0.1, B1.1, C7.1, C45.1, C46.1, C47.1, C48.1, C49.1, C50.1, C51.1, C52.1, C53.1, C54.1, C55.1, C56.1, COM.19, COM.20, I/O.17, IC1.6 (VDD), JTAG.1, L3.1, SERIAL.19, SERIAL.20, U$2.11 (VDD), U$2.19 (VDD1), U$2.28 (VDD2), U$2.50 (VDD3), U$2.75 (VDD4), U$2.100 (VDD5); also elsewhere on the board
+5V: C6.1, COM.15, COM.16, I/O.19, IC1.7 (REGIN), IC1.8 (VBUS), SERIAL.15, SERIAL.16, SJ1.2
+12V: I/O.20; also elsewhere on the board
BOOT0: R5.2, U$2.94 (BOOT0)
BOOT1: R4.2, U$2.37 (PB2)
CAN1_RX: COM.6, U$2.70 (PA11)
CAN1_TX: COM.5, U$2.71 (PA12)
ESP_RX: COM.8, U$2.91 (PB5)
ESP_TX: COM.7, JTAG.6, U$2.89 (PB3)
ETH_MISO: COM.3, U$2.31 (PA6)
ETH_MOSI: COM.4, U$2.32 (PA7)
ETH_SCK: COM.2, U$2.30 (PA5)
ETH_SS: COM.1, U$2.29 (PA4)
GND: B0.3, B1.3, C6.2, C7.2, C10.2, C11.2, C12.2, C13.2, C42.1, C43.2, C44.2, C45.2, C46.2, C47.2, C48.2, C49.2, C50.2, C51.2, C52.2, C53.2, C54.2, C55.2, C56.2, C65.2, C66.2, C68.2, C69.2, COM.17, COM.18, I/O.15, I/O.16, IC1.3 (GND), IC1.EXP (GND), IC1.M (GND), R8.1, R9.1, RESET.2, SERIAL.13, SERIAL.14, SERIAL.17, SERIAL.18, U$2.10 (VSS), U$2.20 (VSSA), U$2.27 (VSS1), U$2.74 (VSS2), U$2.99 (VSS3), X2.4, X2.S1, X2.S2; also elsewhere on the board
unnamed: B1.2, R4.1
unnamed: B0.2, R5.1
unnamed: IC1.9 (!RST), R7.2, R8.2
unnamed: C11.1, Q1.2, R13.1
unnamed: C12.1, Q2.2, R15.1
unnamed: IC1.2 (RI), JP1.3
unnamed: C13.1, Q2.1, R14.1
unnamed: IC1.5 (D-), X2.2
unnamed: IC1.4 (D+), X2.3
unnamed: C44.1, U$2.73 (VCAP_2)
unnamed: L1.2, R7.1, X2.1
unnamed: F1.2, L1.1
unnamed: IC1.1 (DCD), JP1.4
unnamed: C43.1, U$2.49 (VCAP_1)
unnamed: IC1.11 (!SUSPEND), JP1.2, R9.2
unnamed: IC1.12 (SUSPEND), JP1.1
unnamed: IC1.28 (DTR), JP1.5
unnamed: CTS.1, IC1.24 (RTS)
unnamed: IC1.23 (CTS), RTS.1
NRF_RX: COM.11, U$2.93 (PB7)
NRF_TX: COM.10, U$2.92 (PB6)
PB4: COM.9, U$2.90 (PB4)
PB8: COM.12, U$2.95 (PB8)
PB12: U$2.51 (PB12)
PB13: U$2.52 (PB13)
PC0: U$2.15 (PC0)
PC1: U$2.16 (PC1)
PC2: U$2.17 (PC2)
PC3: U$2.18 (PC3)
PC4: U$2.33 (PC4)
PC5: U$2.34 (PC5)
PC6: U$2.63 (PC6)
PC7: U$2.64 (PC7)
PC13: U$2.7 (PC13)
PC14: R15.2, U$2.8 (PC14)
PC15: R14.2, U$2.9 (PC15)
PD0: U$2.81 (PD0)
PD1: U$2.82 (PD1)
PD7: U$2.88 (PD7)
PD8: U$2.55 (PD8)
PD9: U$2.56 (PD9)
PD10: U$2.57 (PD10)
PD11: U$2.58 (PD11)
PD12: U$2.59 (PD12)
PD13: U$2.60 (PD13)
PD14: U$2.61 (PD14)
PD15: U$2.62 (PD15)
PE0: I/O.1, U$2.97 (PE0)
PE1: I/O.2, U$2.98 (PE1)
PE2: I/O.3, U$2.1 (PE2)
PE3: I/O.4, U$2.2 (PE3)
PE4: I/O.5, U$2.3 (PE4)
PE5: I/O.6, U$2.4 (PE5)
PE6: I/O.7, U$2.5 (PE6)
PE7: I/O.8, U$2.38 (PE7)
PE8: I/O.9, U$2.39 (PE8)
PE9: I/O.10, U$2.40 (PE9)
PE10: I/O.11, U$2.41 (PE10)
PE11: I/O.12, U$2.42 (PE11)
PE12: I/O.13, U$2.43 (PE12)
PE13: I/O.14, U$2.44 (PE13)
PE14: U$2.45 (PE14)
PE15: U$2.46 (PE15)
PH0: R13.2, U$2.12 (PH0)
PH1: C10.1, Q1.1, U$2.13 (PH1)
REG_5V: SJ1.3; also elsewhere on the board
RESET: C42.2, RESET.1, U$2.14 (NRST)
RESET#: JTAG.7
RX1: SERIAL.2, U$2.36 (PB1)
RX2: SERIAL.4, U$2.26 (PA3)
RX3: SERIAL.6, U$2.48 (PB11)
RX4: SERIAL.8, U$2.24 (PA1)
RX5: SERIAL.10, U$2.68 (PA9)
RX6: SERIAL.12, U$2.96 (PB9)
SD_CMD: U$2.83 (PD2)
SD_D0: U$2.65 (PC8)
SD_D1: U$2.66 (PC9)
SD_D2: U$2.78 (PC10)
SD_D3: U$2.79 (PC11)
SD_SCK: U$2.80 (PC12)
TCK/SWCLK: JTAG.5, U$2.76 (PA14)
TDI: JTAG.3, U$2.77 (PA15)
TMS/SWDIO: JTAG.4, U$2.72 (PA13)
TRST: JTAG.2
TX1: SERIAL.1, U$2.35 (PB0)
TX2: SERIAL.3, U$2.25 (PA2)
TX3: SERIAL.5, U$2.47 (PB10)
TX4: SERIAL.7, U$2.23 (PA0)
TX5: SERIAL.9, U$2.67 (PA8)
TX6: SERIAL.11, U$2.69 (PA10)
USART2_CTS: CTS.2, U$2.84 (PD3)
USART2_RTS: RTS.2, U$2.85 (PD4)
USART2_RX: IC1.26 (TXD), U$2.87 (PD6)
USART2_TX: IC1.25 (RXD), U$2.86 (PD5)
USB_OTG_HS_DM: COM.13, U$2.53 (PB14)
USB_OTG_HS_DP: COM.14, U$2.54 (PB15)
VBAT: U$2.6 (VBAT)
VDDA: C65.1, C68.1, L3.2, R21.2, U$2.22 (VDDA)
VIN: I/O.18; also elsewhere on the board
VREF+: C66.1, C69.1, R21.1, U$2.21 (VREF+)
VUSB2: F1.1, SJ1.1

Notes on the sheet:
JTAG connector
NOTE: +3V3 is VDD_MCU
MICROCONTROLLER - STM32F407/417
POWER DECOUPLING CAPACITORS
USB-UART Bridge
(RX0)
(TX0)

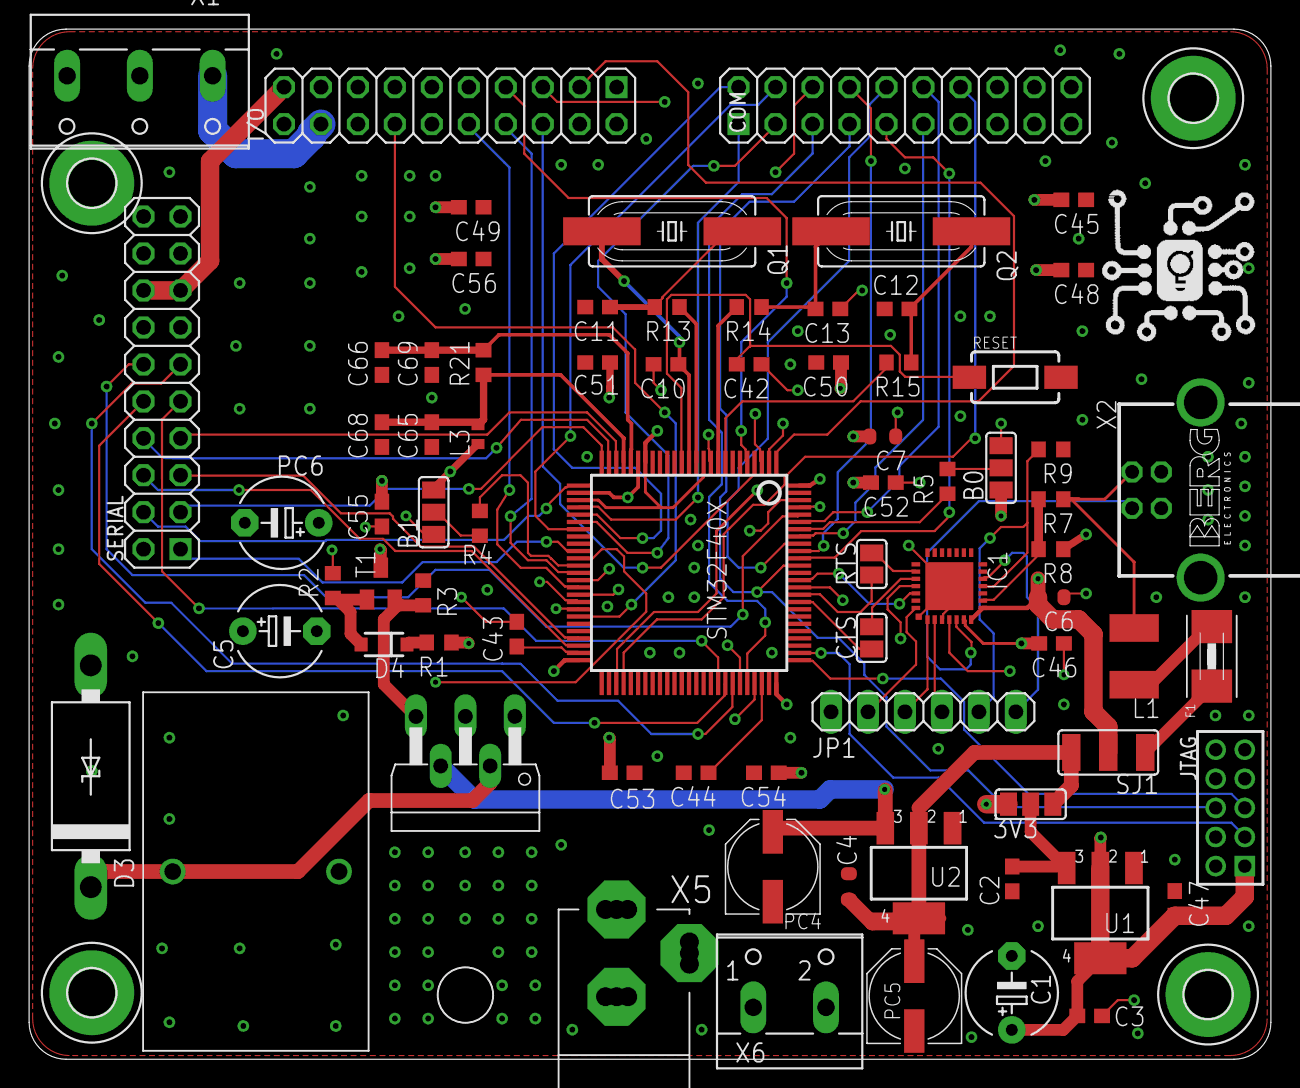
[picture p15: board schema_mpb1_1.brd from above]

Board: 4 copper layers, 85.3 x 70.8 mm, 79 parts (0 on the bottom side), 87 nets.
