felixomwansa/Multi-Protocol-Board---MPB-01/v1 blocks - Reference/v1_schematic.brd

## EAGLE design v1 blocks - Reference/v1_schematic.brd (2019-05-13)

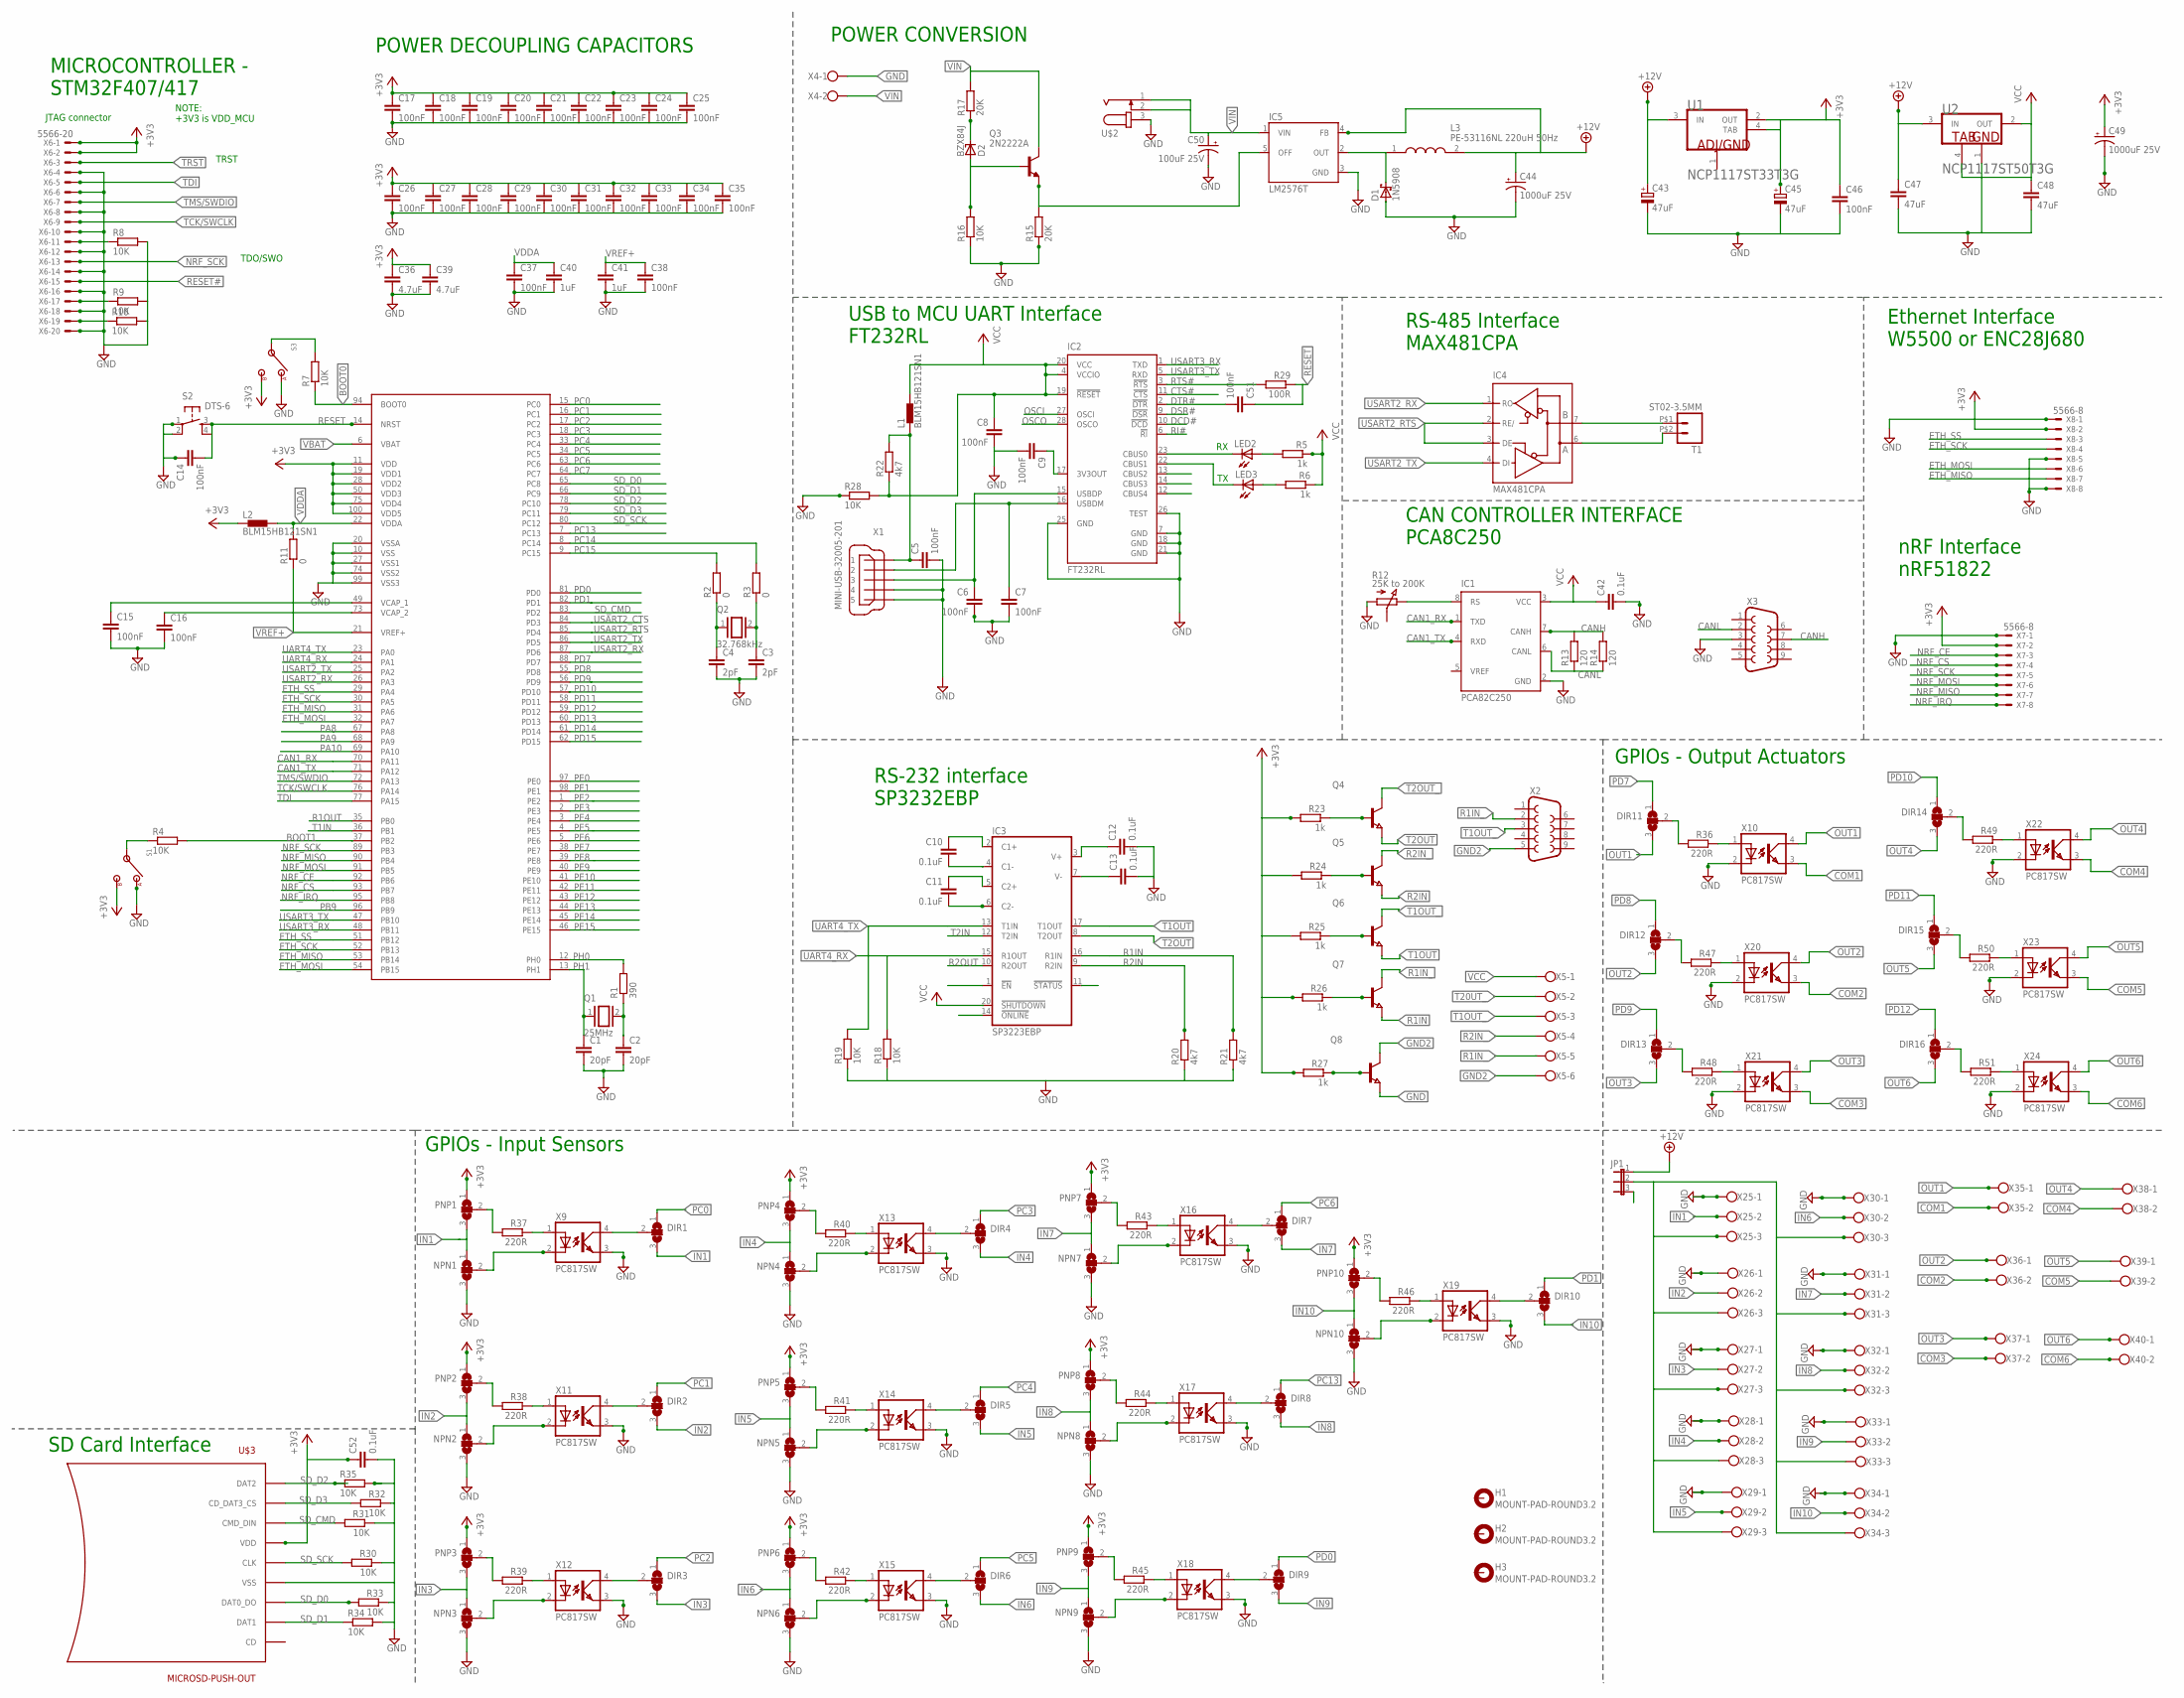
[picture p16: schematic v1_schematic.sch]

Parts:
C1, C2: 20pF; C0805
C3, C4: 2pF; C0805
C5, C6, C7, C8, C9, C14, C15, C16, C17, C18, C19, C20, C21, C22, C23, C24, C25, C26, C27, C28, C29, C30, C31, C32, C33, C34, C35, C37, C38, C51: 100nF; C0805
C10, C11, C12, C13, C42, C52: 0.1uF; C0805
C36, C39: 4.7uF; C0805
C40, C41: 1uF; C0805
C43, C45: 47uF; 153CLV-1014
C44, C49: 1000uF 25V; E5-6
C46: 100nF; 0603-CAP
C47, C48: 47uF; 0603-CAP
C50: 100uF 25V; E5-6
D1: 1N5908; C4111-15
D2: BZX84J; SOD323(F)
DIR1, DIR2, DIR3, DIR4, DIR5, DIR6, DIR7, DIR8, DIR9, DIR10, DIR11, DIR12, DIR13, DIR14, DIR15, DIR16: SJ2WW; SJ_2W
H1, H2, H3: MOUNT-PAD-ROUND3.2; 3,2-PAD
IC1: PCA82C250; DIL08
IC2: FT232RL; SSOP28
IC3: SP3223EBP; DIL20
IC4: MAX481CPA; DIL08
IC5: LM2576T; TO220-5
JP1: JP2W
L1, L2: BLM15HB121SN1; 0402
L3: PE-53116NL 220uH 50Hz; PE-53116NL
LED2, LED3: LEDSML0805; SML0805
NPN1, NPN2, NPN3, NPN4, NPN5, NPN6, NPN7, NPN8, NPN9, NPN10: SJ2WW; SJ_2W
PNP1, PNP2, PNP3, PNP4, PNP5, PNP6, PNP7, PNP8, PNP9, PNP10: SJ2WW; SJ_2W
Q1: 25MHz; QS
Q2: 32.768kHz; QS
Q3: 2N2222A; TO18
Q4, Q5, Q6, Q7, Q8: NPN-TRANSISTOR_SOT23; SOT23
R1: 390; R0805
R2, R3, R11: 0; R0805
R4, R7, R8, R9, R10, R16, R18, R19, R28, R30, R31, R32, R33, R34, R35: 10K; R0805
R5, R6, R23, R24, R25, R26, R27: 1k; R0805
R12: 25K to 200K; PC25
R13, R14: 120; R0805
R15, R17: 20K; R0805
R20, R21, R22: 4k7; R0805
R29: 100R; R0805
R36, R37, R38, R39, R40, R41, R42, R43, R44, R45, R46, R47, R48, R49, R50, R51: 220R; R0805
S1, S3: STS121PC04
S2: DTS-6
T1: ST02-3.5MM; ED350V-02P
U1: ON_SEMICONDUCTOR_NCP1117ST33T3GON_SEMICONDUCTOR_N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; ON_SEMICONDUCTOR_NCP1117ST33T3G_0
U2: ON_SEMICONDUCTOR_NCP1117ST50T3GON_SEMICONDUCTOR_N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; ON_SEMICONDUCTOR_NCP1117ST50T3G_2
U$1: STM32F40XSTM32D40X; LQFP100
U$2: JACK-PLUG1; SPC4078
U$3: MICROSD-PUSH-OUT
X1: MINI-USB-32005-201; 32005-201
X2, X3: F09VB
X4, X35, X36, X37, X38, X39, X40: W237-102
X5: W237-6
X6: 5566-20
X7, X8: 5566-8
X9, X10, X11, X12, X13, X14, X15, X16, X17, X18, X19, X20, X21, X22, X23, X24: PC817SW; PC817SMTW
X25, X26, X27, X28, X29, X30, X31, X32, X33, X34: W237-103

Connections:
+3V3: C17.1, C18.1, C19.1, C20.1, C21.1, C22.1, C23.1, C24.1, C25.1, C26.1, C27.1, C28.1, C29.1, C30.1, C31.1, C32.1, C33.1, C34.1, C35.1, C36.1, C39.1, C45.+, C46.1, C49.+, C52.1, L2.1, PNP1.1, PNP2.1, PNP3.1, PNP4.1, PNP5.1, PNP6.1, PNP7.1, PNP8.1, PNP9.1, PNP10.1, R23.2, R24.2, R25.2, R26.2, R27.2, S1.3, S3.3, U1.2 (OUT), U1.4 (TAB), U$1.11 (VDD), U$1.19 (VDD1), U$1.28 (VDD2), U$1.50 (VDD3), U$1.75 (VDD4), U$1.100 (VDD5), U$3.4 (VDD), X6.1, X6.2, X7.2, X8.2
+12V: C43.+, C44.+, C47.1, IC5.4 (FB), JP1.1, L3.2, U1.3 (IN), U2.3 (IN)
BOOT0: R7.1, U$1.94 (BOOT0)
BOOT1: R4.2, U$1.37 (PB2)
CAN1_RX: IC1.1 (TXD), U$1.70 (PA11)
CAN1_TX: IC1.4 (RXD), U$1.71 (PA12)
CANH: IC1.7 (CANH), R13.2, R14.2, X3.7
CANL: R13.1, R14.1, X3.2
COM1: X10.3 (EMIT), X35.2
COM2: X20.3 (EMIT), X36.2
COM3: X21.3 (EMIT), X37.2
COM4: X22.3 (EMIT), X38.2
COM5: X23.3 (EMIT), X39.2
COM6: X24.3 (EMIT), X40.2
CTS#: IC2.11 (!CTS)
DCD#: IC2.10 (!DCD)
DSR#: IC2.9 (!DSR)
DTR#: C51.2, IC2.2 (!DTR)
ETH_MISO: U$1.31 (PA6), U$1.53 (PB14), X8.7
ETH_MOSI: U$1.32 (PA7), U$1.54 (PB15), X8.6
ETH_SCK: U$1.30 (PA5), U$1.52 (PB13), X8.4
ETH_SS: U$1.29 (PA4), U$1.51 (PB12), X8.3
GND: C1.2, C2.2, C3.2, C4.2, C5.2, C6.2, C7.2, C8.2, C9.2, C12.2, C13.2, C14.1, C15.2, C16.2, C17.2, C18.2, C19.2, C20.2, C21.2, C22.2, C23.2, C24.2, C25.2, C26.2, C27.2, C28.2, C29.2, C30.2, C31.2, C32.2, C33.2, C34.2, C35.2, C36.2, C37.2, C38.2, C39.2, C40.2, C41.2, C42.2, C43.-, C44.-, C45.-, C46.2, C47.2, C48.2, C49.-, C50.-, C52.2, D1.A, IC1.2 (GND), IC2.7 (GND), IC2.18 (GND), IC2.21 (GND), IC2.25 (GND), IC2.26 (TEST), IC3.18 (GND), IC4.5 (GND), IC5.3 (GND), NPN1.3, NPN2.3, NPN3.3, NPN4.3, NPN5.3, NPN6.3, NPN7.3, NPN8.3, NPN9.3, NPN10.3, Q8.2 (E), R8.2, R9.2, R10.2, R12.A, R15.1, R16.1, R18.1, R19.1, R20.1, R21.1, R28.1, R30.1, R31.1, R32.1, R33.1, R34.2, R35.2, S1.1, S2.1, S2.2, S3.1, U2.1 (GND), U$1.10 (VSS), U$1.20 (VSSA), U$1.27 (VSS1), U$1.74 (VSS2), U$1.99 (VSS3), U$2.3, U$3.6 (VSS), U$3.G1 (VSS), U$3.G2 (VSS), U$3.G3 (VSS), U$3.G4 (VSS), X1.4, X1.5, X3.3, X4.1, X6.4, X6.6, X6.8, X6.10, X6.12, X6.14, X6.16, X6.18, X6.20, X7.1, X8.1, X8.5, X8.8, X9.3 (EMIT), X10.2 (C), X11.3 (EMIT), X12.3 (EMIT), X13.3 (EMIT), X14.3 (EMIT), X15.3 (EMIT), X16.3 (EMIT), X17.3 (EMIT), X18.3 (EMIT), X19.3 (EMIT), X20.2 (C), X21.2 (C), X22.2 (C), X23.2 (C), X24.2 (C), X25.1, X26.1, X27.1, X28.1, X29.1, X30.1, X31.1, X32.1, X33.1, X34.1
GND2: Q8.3 (C), X2.5, X5.6
IN1: DIR1.3, NPN1.1, PNP1.3, X25.2
IN2: DIR2.3, NPN2.1, PNP2.3, X26.2
IN3: DIR3.3, NPN3.1, PNP3.3, X27.2
IN4: DIR4.3, NPN4.1, PNP4.3, X28.2
IN5: DIR5.3, NPN5.1, PNP5.3, X29.2
IN6: DIR6.3, NPN6.1, PNP6.3, X30.2
IN7: DIR7.3, NPN7.1, PNP7.3, X31.2
IN8: DIR8.3, NPN8.1, PNP8.3, X32.2
IN9: DIR9.3, NPN9.1, PNP9.3, X33.2
IN10: DIR10.3, NPN10.1, PNP10.3, X34.2
unnamed: PNP1.2, R37.2
unnamed: C15.1, U$1.49 (VCAP_1)
unnamed: C2.1, Q1.2, R1.1
unnamed: C5.1, L1.1, R22.2, X1.1
unnamed: C3.1, Q2.2, R3.1
unnamed: C4.1, Q2.1, R2.1
unnamed: C9.1, IC2.17 (3V3OUT)
unnamed: R4.1, S1.2
unnamed: C7.1, IC2.16 (USBDM), X1.2
unnamed: C6.1, IC2.15 (USBDP), X1.3
unnamed: IC2.23 (CBUS0), LED2.C
unnamed: IC2.22 (CBUS1), LED3.C
unnamed: LED3.A, R6.2
unnamed: LED2.A, R5.2
unnamed: C10.2, IC3.4 (C1-)
unnamed: C11.2, IC3.6 (C2-)
unnamed: C11.1, IC3.5 (C2+)
unnamed: C10.1, IC3.2 (C1+)
unnamed: C13.1, IC3.7 (V-)
unnamed: C12.1, IC3.3 (V+)
unnamed: C14.2, S2.3, S2.4
unnamed: R7.2, S3.2
unnamed: IC4.7 (B), T1.P$1 (1)
unnamed: IC1.8 (RS), R12.E
unnamed: IC4.6 (A), T1.P$2 (2)
unnamed: D2.2 (A), Q3.2 (B), R16.2
unnamed: R37.1, X9.1 (A)
unnamed: Q3.1 (E), R15.2
unnamed: NPN1.2, X9.2 (C)
unnamed: D2.1 (C), R17.1
unnamed: JP1.2, X25.3, X26.3, X27.3, X28.3, X29.3, X30.3, X31.3, X32.3, X33.3, X34.3
unnamed: PNP8.2, R44.2
unnamed: C16.1, U$1.73 (VCAP_2)
unnamed: D1.C, IC5.2 (OUT), L3.1
unnamed: DIR1.2, X9.4 (COL)
unnamed: R44.1, X17.1 (A)
unnamed: Q4.1 (B), R23.1
unnamed: R8.1, X6.11
unnamed: Q5.1 (B), R24.1
unnamed: Q6.1 (B), R25.1
unnamed: R9.1, X6.17
unnamed: Q7.1 (B), R26.1
unnamed: Q8.1 (B), R27.1
unnamed: R10.1, X6.19
unnamed: DIR11.2, R36.2
unnamed: R36.1, X10.1 (A)
unnamed: DIR12.2, R47.2
unnamed: PNP2.2, R38.2
unnamed: R38.1, X11.1 (A)
unnamed: NPN2.2, X11.2 (C)
unnamed: NPN8.2, X17.2 (C)
unnamed: DIR2.2, X11.4 (COL)
unnamed: PNP3.2, R39.2
unnamed: R39.1, X12.1 (A)
unnamed: NPN3.2, X12.2 (C)
unnamed: DIR3.2, X12.4 (COL)
unnamed: DIR8.2, X17.4 (COL)
unnamed: PNP4.2, R40.2
unnamed: R40.1, X13.1 (A)
unnamed: NPN4.2, X13.2 (C)
unnamed: DIR4.2, X13.4 (COL)
unnamed: PNP5.2, R41.2
unnamed: R41.1, X14.1 (A)
unnamed: NPN5.2, X14.2 (C)
unnamed: PNP9.2, R45.2
unnamed: DIR5.2, X14.4 (COL)
unnamed: R45.1, X18.1 (A)
unnamed: PNP6.2, R42.2
unnamed: R42.1, X15.1 (A)
unnamed: NPN6.2, X15.2 (C)
unnamed: NPN9.2, X18.2 (C)
unnamed: DIR6.2, X15.4 (COL)
unnamed: PNP7.2, R43.2
unnamed: R43.1, X16.1 (A)
unnamed: NPN7.2, X16.2 (C)
unnamed: DIR7.2, X16.4 (COL)
unnamed: DIR9.2, X18.4 (COL)
unnamed: PNP10.2, R46.2
unnamed: R46.1, X19.1 (A)
unnamed: NPN10.2, X19.2 (C)
unnamed: DIR10.2, X19.4 (COL)
unnamed: R47.1, X20.1 (A)
unnamed: DIR13.2, R48.2
unnamed: R48.1, X21.1 (A)
unnamed: DIR14.2, R49.2
unnamed: R49.1, X22.1 (A)
unnamed: DIR15.2, R50.2
unnamed: R50.1, X23.1 (A)
unnamed: DIR16.2, R51.2
unnamed: R51.1, X24.1 (A)
NRF_CE: U$1.92 (PB6), X7.3
NRF_CS: U$1.93 (PB7), X7.4
NRF_IRQ: U$1.95 (PB8), X7.8
NRF_MISO: U$1.90 (PB4), X7.7
NRF_MOSI: U$1.91 (PB5), X7.6
NRF_SCK: U$1.89 (PB3), X6.13, X7.5
OSCI: IC2.27 (OSCI)
OSCO: IC2.28 (OSCO)
OUT1: DIR11.3, X10.4 (COL), X35.1
OUT2: DIR12.3, X20.4 (COL), X36.1
OUT3: DIR13.3, X21.4 (COL), X37.1
OUT4: DIR14.3, X22.4 (COL), X38.1
OUT5: DIR15.3, X23.4 (COL), X39.1
OUT6: DIR16.3, X24.4 (COL), X40.1
PA8: U$1.67 (PA8)
PA9: U$1.68 (PA9)
PA10: U$1.69 (PA10)
PB9: U$1.96 (PB9)
PC0: DIR1.1, U$1.15 (PC0)
PC1: DIR2.1, U$1.16 (PC1)
PC2: DIR3.1, U$1.17 (PC2)
PC3: DIR4.1, U$1.18 (PC3)
PC4: DIR5.1, U$1.33 (PC4)
PC5: DIR6.1, U$1.34 (PC5)
PC6: DIR7.1, U$1.63 (PC6)
PC7: U$1.64 (PC7)
PC13: DIR8.1, U$1.7 (PC13)
PC14: R3.2, U$1.8 (PC14)
PC15: R2.2, U$1.9 (PC15)
PD0: DIR9.1, U$1.81 (PD0)
PD1: DIR10.1, U$1.82 (PD1)
PD7: DIR11.1, U$1.88 (PD7)
PD8: DIR12.1, U$1.55 (PD8)
PD9: DIR13.1, U$1.56 (PD9)
PD10: DIR14.1, U$1.57 (PD10)
PD11: DIR15.1, U$1.58 (PD11)
PD12: DIR16.1, U$1.59 (PD12)
PD13: U$1.60 (PD13)
PD14: U$1.61 (PD14)
PD15: U$1.62 (PD15)
PE0: U$1.97 (PE0)
PE1: U$1.98 (PE1)
PE2: U$1.1 (PE2)
PE3: U$1.2 (PE3)
PE4: U$1.3 (PE4)
PE5: U$1.4 (PE5)
PE6: U$1.5 (PE6)
PE7: U$1.38 (PE7)
PE8: U$1.39 (PE8)
PE9: U$1.40 (PE9)
PE10: U$1.41 (PE10)
PE11: U$1.42 (PE11)
PE12: U$1.43 (PE12)
PE13: U$1.44 (PE13)
PE14: U$1.45 (PE14)
PE15: U$1.46 (PE15)
PH0: R1.2, U$1.12 (PH0)
PH1: C1.1, Q1.1, U$1.13 (PH1)
R1IN: IC3.16 (R1IN), Q7.2 (E), R21.2
R1IN_: Q7.3 (C), X2.2, X5.5
R1OUT: U$1.35 (PB0)
R2IN: IC3.9 (R2IN), Q5.2 (E), R20.2
R2IN_: Q5.3 (C), X5.4
R2OUT: IC3.10 (R2OUT)
RESET: C51.1, R29.1, U$1.14 (NRST)
RESET#: X6.15
RI#: IC2.6 (!RI)
RTS#: IC2.3 (!RTS), R29.2
SD_CMD: R31.2, U$1.83 (PD2), U$3.3 (CMD_DIN)
SD_D0: R33.2, U$1.65 (PC8), U$3.7 (DAT0_DO)
SD_D1: R34.1, U$1.66 (PC9), U$3.8 (DAT1)
SD_D2: R35.1, U$1.78 (PC10), U$3.1 (DAT2)
SD_D3: R32.2, U$1.79 (PC11), U$3.2 (CD_DAT3_CS)
SD_SCK: R30.2, U$1.80 (PC12), U$3.5 (CLK)
T1IN: U$1.36 (PB1)
T1OUT: IC3.17 (T1OUT), Q6.2 (E)
T1OUT_: Q6.3 (C), X2.3, X5.3
T2IN: IC3.12 (T2IN)
T2OUT: IC3.8 (T2OUT), Q4.2 (E)
T2OUT_: Q4.3 (C)
T20UT_: X5.2
TCK/SWCLK: U$1.76 (PA14), X6.9
TDI: U$1.77 (PA15), X6.5
TMS/SWDIO: U$1.72 (PA13), X6.7
TRST: X6.3
UART4_RX: IC3.15 (R1OUT), R18.2, U$1.24 (PA1)
UART4_TX: IC3.13 (T1IN), R19.2, U$1.23 (PA0)
USART2_CTS: U$1.84 (PD3)
USART2_RTS: IC4.2 (RE/), IC4.3 (DE), U$1.85 (PD4)
USART2_RX: IC4.1 (RO), U$1.26 (PA3), U$1.87 (PD6)
USART2_TX: IC4.4 (DI), U$1.25 (PA2), U$1.86 (PD5)
USART3_RX: IC2.1 (TXD), U$1.48 (PB11)
USART3_TX: IC2.5 (RXD), U$1.47 (PB10)
VBAT: U$1.6 (VBAT)
VCC: C8.1, C42.1, C48.1, IC1.3 (VCC), IC2.4 (VCCIO), IC2.19 (!RESET), IC2.20 (VCC), IC3.19 (VCC), IC3.20 (!SHUTDOWN), IC4.8 (VCC), L1.2, R5.1, R6.1, R22.1, R28.2, U2.2 (OUT), U2.4 (TAB), X5.1
VDDA: C37.1, C40.1, L2.2, R11.2, U$1.22 (VDDA)
VIN: C50.+, IC5.1 (VIN), Q3.3 (C), R17.2, U$2.1, U$2.2, X4.2
VREF+: C38.1, C41.1, R11.1, U$1.21 (VREF+)

Notes on the sheet:
JTAG connector
NOTE: +3V3 is VDD_MCU
MICROCONTROLLER - STM32F407/417
USB to MCU UART Interface FT232RL
RS-232 interface SP3232EBP
CAN CONTROLLER INTERFACE PCA8C250
POWER DECOUPLING CAPACITORS
RS-485 Interface MAX481CPA
POWER CONVERSION
SD Card Interface
TRST
TDO/SWO
Ethernet Interface W5500 or ENC28J680
nRF Interface nRF51822
GPIOs - Input Sensors
GPIOs - Output Actuators

Board: 2 copper layers, 212 parts (0 on the bottom side), 182 nets, no tracks yet.
