felixomwansa/Multi-Protocol-Board---MPB-01/(commit log)

2018-10-18 First Version Design of MPB
    Added barebones designs for MCU with FTDI UART Interface and SP3232 interface:
    - MCU: STM32F407xx, LQFP100 package
    - FTDI: FT232RL
    - SP3232: SP3223EBP
    - Added power connections to main MCUn and JTAG connector
    [v1_schematic.sch]
2018-10-18 Decoupling and fixes
    - Added decoupling capacitor network to MCU
    - Fixes: conventions for component arrangement and enlargement of frame size
    [v1_schematic.sch]
2018-10-19 Updates and fixes
    - completed RS232 interfacing, added DB9 connector
    - added CAN contoller interface with DB9 connector
    [v1_schematic.sch]
2018-10-19 RS-485 Interface
    - added the rs-485 interface to MCU
    [v1_schematic.sch]
2018-10-19 Organization
    - added sections to schematic
    [v1_schematic.sch]
2018-10-24 Power Conversion and References
    - Completed power supply conversion for 5V (VCC) and 3V3.
    - Added STM32F407VETx pinout image for design reference.
    [v1_schematic.sch]
2018-10-24 Corrections
    - Values for various passive parts adjusted.
    [v1_schematic.sch]
2018-10-26 Ethernet Interface
    - added SPI ethernet module interface on SPI1, where MCU is SPI_master while W5100/W5500 module is SPI_slave
    [v1_schematic.sch]
2018-12-03 RS232 Interface
    - Added protection circuitry
    - Corrected a few connections
    [v1_schematic.sch]
2018-12-03 SD Card Interface
    - Added SD card interface based on
    SD MEMORY CARD PUSH-PUSH WITH CONNECTOR TYPE B
    Package Type: SDBMF-009XXBXX2
    [v1_schematic.sch]
2018-12-04 Corrections
    - Adjusted FT2323 interface to USART1 and completed Interface connections
    [v1_schematic.sch]
2018-12-04 Ethernet
    -Connected Ethernet interface to SPI2 - PB12-PB15
    [v1_schematic.sch]
2018-12-04 SD Interface
    - Completed SD interfacing to SDIO of MCU (PD2, PC8-PC12)
    [v1_schematic.sch]
2018-12-04 NRF Interface and corrections
    - Correction: Moved FT232 Interface to USART3
    - Completed NRF interface to SPI1 of MCU (PB3-PB8)
    [v1_schematic.sch]
2018-12-04 Organization
    - Minor adjustments to arrangement
    - Added reference schematic for STMF4VEx
    [v1_schematic.sch]
2018-12-06 GPIOs
    - Added input and output GPIO interfaces
    [v1_schematic.sch]
2018-12-06 GPIOs
    - Added terminals for GPIO connection
    [v1_schematic.sch]
2018-12-07 Updates
    - Completed GPIO-MCU connection
    - Changed labels to tags for easier visibility
    [v1_schematic.sch]
2018-12-07 Mount-Pads
    Added mount Pads
    [v1_schematic.sch]
2018-12-07 Board
    - Added dimension
    [v1_schematic.brd]
2018-12-08 SD Card Interface
    - Changed interface to T-Flash Push-Out Micro SD Card Reader 14.75mm x 14.5mm SMD with external pins (smaller footprint)
    [v1_schematic.sch]
2018-12-08 JTAG connector
    - Changed JTAG connector to dual row
    [v1_schematic.brd, v1_schematic.sch]
2019-01-16 Minor Board Edits
    [v1_schematic.brd]
2019-05-13 V2
    Created new layout template
    [Main board.brd, Main board.sch, schema_mpb1_1.brd, schema_mpb1_1.sch, v1_schematic.brd, v1_schematic.sch]
2019-06-25 UPDATE
    Updated design for Main board and I/O
    - Reduced form factor, boards will be interconnected using ribbon cable connectors on 20-pin headers
    [schema_mpb1_1.brd, schema_mpb1_1.sch, schema_mpb1_1_IO.brd, schema_mpb1_1_IO.sch, v1_schematic.brd, v1_schematic.sch]
2019-06-26 Routing
    First draft of routing tracks for main board
    [schema_mpb1_1.brd, schema_mpb1_1.sch]
2019-06-28 Power Tracks
    Routed main power tracks for Main board PCB
    [schema_mpb1_1.brd, schema_mpb1_1.sch]
2019-06-28 Board dimensions
    Added board dimensions
    [schema_mpb1_1.brd]
2019-06-28 First Draft
    Completed routing of first draft for main board
    [schema_mpb1_1.brd, schema_mpb1_1.sch]
2019-06-28 Layer colours
    Changed layer colour fill to solid
    [schema_mpb1_1.brd]
2019-06-28 Orientation
    Changed board orientation to horizontal
    [schema_mpb1_1.brd]
2019-07-05 First Revision
    - Added 3 PIN terminal block for power
    - Cleaned up tracks /rerouted
    [schema_mpb1_1.brd, schema_mpb1_1.sch, schema_mpb1_1_IO.brd, schema_mpb1_1_IO.sch, schema_mpb_1_1_Serial.brd, schema_mpb_1_1_Serial.sch]
2019-07-08 IO board tracks
    - Routed first version of IO board, added dimensions
    [schema_mpb1_1.brd, schema_mpb1_1_IO.brd, schema_mpb1_1_IO.sch]
2019-07-09 IO Board revision
    - Fixed GND airwires
    - Resolved width errors
    [schema_mpb1_1_IO.brd, schema_mpb1_1_IO.sch]
2019-07-09 IO board. Routing from connector changed. GND vias added
    [schema_mpb1_1_IO.brd, schema_mpb1_1_IO.sch]
2019-07-09 RS232 Board
    Routed tracks and added dimensions
    [schema_mpb_1_1_Serial.brd, schema_mpb_1_1_Serial.sch]
2019-07-09 IO board
    - Added mounting holes and terminal labels
    [schema_mpb1_1_IO.brd, schema_mpb1_1_IO.sch]
2019-07-10 Organisation
    - Created new folder for COM board
    [schema_mpb1_1.brd, schema_mpb1_1.sch, schema_mpb_1_1_COM.sch, schema_mpb_1_1_Serial.brd, schema_mpb_1_1_Serial.sch, v1_schematic.brd, v1_schematic.sch]
2019-07-11 Main board
    - Rounded corners (2.54mm setting)
    - Placed final mounting pad
    [schema_mpb1_1.brd, schema_mpb_1_1_COM.brd, schema_mpb_1_1_COM.sch]
2019-07-11 IO and Serial
    - Rounded corners
    [schema_mpb1_1_IO.brd, schema_mpb_1_1_Serial.brd]
2019-07-11 Main board
    - Tidy routes
    [schema_mpb1_1.brd, schema_mpb1_1.sch]
2019-07-12 Main board revisions
    - Rerouted long tracks to other layers
    [schema_mpb1_1.brd, schema_mpb_1_1_COM.brd, schema_mpb_1_1_COM.sch]
2019-07-16 Main board
    - Tidied tracks
    [schema_mpb1_1.brd, schema_mpb_1_1_COM.brd, schema_mpb_1_1_COM.sch]
2019-07-17 COM board
    - Routed first version of Wireless COM board
    [schema_mpb1_1.brd, schema_mpb1_1.sch, schema_mpb_1_1_COM.brd, schema_mpb_1_1_COM.sch]
2019-07-17 Logos
    Added Geviton Logo to designs
    [schema_mpb1_1.brd, schema_mpb1_1.sch, schema_mpb1_1_IO.brd, schema_mpb1_1_IO.sch, schema_mpb_1_1_COM.brd, schema_mpb_1_1_COM.sch]
2019-07-17 Main board
    Changed drill size of vias to 0.4mm
    [schema_mpb1_1.brd]
2019-07-17 Main board
    Applied ground stitching
    [schema_mpb1_1.brd]
2019-07-18 Wireless board
    - Changed drill sizes, got rid of via clearance issues
    [schema_mpb_1_1_COM.brd, schema_mpb_1_1_COM.sch]
2019-08-02 IO board revision
    - Made Output traces thicker
    - Added pad for 5V/3.3V power for input sensors
    [schema_mpb1_1_IO.brd, schema_mpb1_1_IO.sch, schema_mpb_1_1_Serial.brd]
2019-08-02 COM revision
    - Added Ethernet module outline
    - Adjusted track width
    - labelled CAN terminals
    [schema_mpb_1_1_COM.brd, schema_mpb_1_1_COM.sch]
2019-08-02 Serial Board Revision
    - Labelled terminals
    [schema_mpb_1_1_Serial.brd]
