felixomwansa/Multi-Protocol-Board---MPB-01/(notices)

Notices in the files:
parts and their libraries:
esp32: Creative Commons Attribution-ShareAlike 4.0 International
SparkFun-Capacitors: Licensing: CC v3.0 Share-Alike You are welcome to use this library for commercial purposes.
